ashtuchkin/vive-diy-position-sensor/(threads)

Thread 1 (2016-10-31):

Pictures for readme.md

ashtuchkin, 2016-10-31:
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

!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

[image](https://cloud.githubusercontent.com/assets/627997/19845426/06c64bb2-9ef4-11e6-8d2b-1bbfbc5ec368.png)

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

ashtuchkin, 2016-11-07:
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

ashtuchkin, 2016-11-13:
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

ashtuchkin, 2016-11-13:
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

ashtuchkin, 2016-11-13:
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

ashtuchkin, 2016-11-13:
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

ashtuchkin, 2016-11-13:
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

ashtuchkin, 2016-11-13:
| Top view | Bottom view |
| --- | --- |
| 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 | 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 |

ashtuchkin, 2016-11-13:
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

ashtuchkin, 2016-11-13:
| Teensy connections |  Full position tracker |
| --- | --- |
| 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 | 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 |

ashtuchkin, 2016-11-28:
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

ashtuchkin, 2016-11-28:
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

Closed 2016-10-31.

Thread 2 (2016-11-13):

Create a more convenient method of providing base station geometry.

ashtuchkin, 2016-11-13:
Base station positions and direction matrices are hardcoded in geometry.cpp (`lightsources`).

I'm currently using an [OpenVR](https://github.com/ValveSoftware/openvr) hello world sample on my main machine to get it (by inspecting m_rmat4DevicePose in debug mode). This is obviously not sustainable.

Subtasks:
 - [x] Keep the matrices in EEPROM.
 - [x] Create interface to set them via USB.
 - [x] Create a way to determine the matrices for a setup - special application?

paralin, 2016-12-01:
The real Vive controllers and headset do it automatically, since they have a lot of sensors and know the exact geometry of all of those sensors, it must be quite easy to derive the positions of the base stations. The room calibration is primarily used to figure out the ground + play area, I suppose. The official sensors can determine the base stations relative positions without calibration or pre-set values. I think it would be possible for us to do this as well *if* we have multiple sensors on the quad with pre-calibrated positions

mpinner, 2016-12-08:
I'd be interested to ease the process by which we're to determine the positions and direction matrices. I got the OpenVR project working am able to inspect the m_rmat4DevicePose as well. The data from there (int[16]) didn't match format of our lightsources[2] (See Below)

I was thinking i could build a little windows app that outputs the correct lighthouse calibration information (direction and position). i agreed the eeprom is a nice way to go. i'll look into something there as well.

thanks for all your work and documentation.

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

ashtuchkin, 2016-12-08:
Yeah, as you can see the matrix there is 4x4 with the last column being
(0,0,0,1). For lightsource I'm using the top-left 3x3 sub-matrix (rotation)
and 1x3 position which is the last row of the 4x4 matrix above.

--
Alexander Shtuchkin

On Thu, Dec 8, 2016 at 10:41 AM, matt pinner <notifications@github.com>
wrote:

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

mpinner, 2016-12-12:
Super. this worked great. Thanks!

all the HTTCC devices are in there. it is fascinating getting the positioning matrices for all the device.

 i wonder what it takes to build your own into the system?

ashtuchkin, 2017-01-23:
I updated the project to allow runtime configuration (with data stored in eeprom) and created a small app to easily get the base station geometry in needed format (https://github.com/ashtuchkin/vive-diy-position-sensor-geometry-getter). Will update the docs soon.

Closed 2017-01-23.

Thread 4 (2016-12-05):

TS3633-CM1 Module

abencomo, 2016-12-05:
Hi Alexander,

Will it possible to use the [TS3633-CM1 Module](https://www.triadsemi.com/product/ts3633-cm1/) instea of building your own [sensor board](https://cloud.githubusercontent.com/assets/627997/19845384/a4fce0e4-9ef3-11e6-95e4-6567ff374ee0.png)?

ashtuchkin, 2016-12-05:
I haven't tried it yet, but it should.

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

abencomo, 2016-12-06:
I ordered a few of the TS3633-CM1 Module so I'll let you know if it works.

I noticed that you use three(3) photodiodes optical sensors, but it seems that only one pin is connected from the Teensy to the TLV2462IP.  Are you fussing the values from the optical sensors?

BTW, I was able to build your project (i.e. the firmware) using eclipse as shown below.

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

ashtuchkin, 2016-12-06:
Cool! I think I'll be able to experiment with TS3633-CM1 as well, but I definitely want to hear from you as well!

Yeah, those 3 photodiodes are connected in parallel to make it possible to cover the whole top hemisphere. It works fine, as the beam is almost as large as the gap between them and it looks like just a wider pulse.

I'm glad you compiled it in eclipse - did you need to do anything special? Should I add additional instructions?

abencomo, 2016-12-07:
No, I didn't.  You did such a good job setting up the code that everything worked out of you repo.  BTW, are you in the bay area near SF?

ashtuchkin, 2016-12-07:
That's great :) yeah I live in SF

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

abencomo, 2016-12-07:
Great, I'm at Ames (Moffett Field) near you.  I should have the TS3633-CM1 by Thursday or Friday. Cheers!

abencomo, 2016-12-20:
Hi Alex,

The TS3633-CM1 modules are in backorder so they haven't arrived yet.  In the meantime, I want to confirm a few things.

Are you using only one Vive Base Station in your video?  If that is the case, then did you switch it to mode "A"?

Is the Vive Base Station connected to your laptop via Bluetoorh?

And, do you need to have SteamVR running in your laptop?

Cheers!

ashtuchkin, 2016-12-20:
Hey Al,

> Are you using only one Vive Base Station in your video? If that is the case, then did you switch it to mode "A"?
No, both are used. It's actually exactly the same setup as I use for regular Vive games. Modes B and C

> Is the Vive Base Station connected to your laptop via Bluetoorh?
I have a gaming desktop and they are probably connected via Bluetooth, yes.

> And, do you need to have SteamVR running in your laptop?
I have SteamVR running, but it's just to wake up the stations. AFAIK there's no realtime communication between the stations and desktop.

abencomo, 2016-12-20:
Hum? That means you have a HMD in the loop.  Darn it.  It would have been great if only your IR receiving sensor with the Teensy and the base stations were the only components required.

ashtuchkin, 2016-12-20:
Well, after waking stations up I can shut down desktop and hmd, so it's not
involved. Only base stations and sensor are needed.

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

ashtuchkin, 2016-12-20:
You can also set up base stations to not go to sleep at all

On Mon, Dec 19, 2016 at 5:55 PM Alexander Shtuchkin <ashtuchkin@gmail.com>
wrote:

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

abencomo, 2016-12-20:
Keeping them from going to sleep is a good suggestion.  However, you still need the hmd to initiate the system before the quadcopter takes off, correct?

I also noticed that in your videos you're using a Mac laptop, were you able to run SteamVR on the Mac?

Thanks Alex for taking the time to clarify all these things.

ashtuchkin, 2016-12-20:
 I'm not sure, but just connecting base stations to power seems to be
enough to initiate. The system's geometry is a different  case - for now,
you need to calibrate the room using Vive's calibration and copy/paste the
matrices to the sensor. After that, only base stations are needed.

AFAIK SteamVR is not supported on Mac. I have a Windows gaming pc to play
vive.

--
Alexander Shtuchkin

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

mpinner, 2016-12-20:
the TS3633-CM1 Module works great!

@ashtuchkin i made a blog post highlighting your work:
https://blog.crashspace.org/2016/12/position-aware-device/

thanks again!

abencomo, 2016-12-20:
That is great. Thanks @mpinner for confirming that!  Now I cannot wait until mine arrived. Santa please, I have been good this year.

ashtuchkin, 2016-12-26:
I just received TS3633-CM1 module and checked it's output with oscilloscope, looks great, should work with the code in this repo with minor adjustment due to inverted envelope:

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
Channel 1: TS3633-CM1
Channel 2: Valve's own sensor (Alan Yates sent me a bunch)
Channel 3: My DIY sensor.

abencomo, 2016-12-31:
Hi Alex,

Are you planning to update the repository with those minor adjustments to handle the inverted envelope?

ashtuchkin, 2017-01-01:
Yep, as soon as I'm back from a vacation in mid jan. Open for PRs if you
need it faster, though.

--
Alexander Shtuchkin

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

erwincoumans, 2017-01-07:
Very cool, can you explain how to connect the TS3633-CM1 to Teensy and what minor changes are needed?

erwincoumans, 2017-01-07:
Great, I used Adrian Wong's change and connected the TS3633-CM1 to Teensy 3.2 and it works.
See image at the bottom here: https://github.com/erwincoumans/vive-diy-position-sensor#ts3633-cm1

How can we connect multiple TS3633-CM1 sensors?

almostsquare, 2017-01-10:
Pull request for inverted envelope along with changes in anticipation of servicing 4+ TS3633-CM1 sensors is available at https://github.com/ashtuchkin/vive-diy-position-sensor/pull/10. Instructions on how to modify board wiring to run side-by-side is provide in the PR.

This is my first PR, so please provide any feedback. I may not be structuring it correctly, so I'm happy to change things around as needed.

Thread 5 (2016-12-07):

STL for 3D printed part

cmcollander, 2016-12-07:
My apologies if this is already posted but I just missed it.
Could you publish the STL file for the 3D printed part?
Thanks!

r1b4z01d, 2019-01-21:
I know this is years old but here is a jig I created for the IR sensors.
https://github.com/r1b4z01d/microz01d/blob/master/SensorJig.stl

Closed 2020-12-07.

Thread 6 (2016-12-08):

Add 1-click-bom file

abencomo, 2016-12-08:
With Digikey you also just share your cart already loaded as shown here:

http://www.digikey.com/short/3595z7

Thread 7 (2016-12-15):

Questions: Trying to reproduce the setup

imuguruza, 2016-12-15:
Hey there,

I'm trying to reproduce your results. Firstly I'm checking that the hardware I have mounted is OK. I have reproduced you schematics in a board that looks like this:

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

I have placed 2 photodiodes, turned ~180º a positioned one of each lighthouses in fron of each photodiode. Once turned on, I'm seeing the next signal at the output of the 2nd OpAmp:

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

Classifying the signals:
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

(I have seen that there are 4 different group of pulses and starts over again)

I have noted down sync pulses and hits. As can be observed, in the 3rd & 4th, there are two hits. I'm not sure why this happens.

This are my doubts:

- The 2 sync pulses are not separated in 400us, I'm seeing ~2.4ms:
- In 3rd and 4th group of pulse, I'm seeing 4 pulses( 2x sync + 2x hits), does this means I'm seeing a kind of reflection or that in that period I'm reading in both photodiodes the ray which has been sent by one of the lightshouse? Are you also reading something like this?

As far as I understand, the pulses generated using 2 lighthouses are:

- 1x sync (lighthouse A) + 1x sync (lighthouse B) + 1x Horizontal lighthouse A
- 1x sync (lighthouse A) + 1x sync (lighthouse B) + 1x Vertical lighthouse A
- 1x sync (lighthouse A) + 1x sync (lighthouse B) + 1x Horizontal lighthouse B
- 1x sync (lighthouse A) + 1x sync (lighthouse B) + 1x Vertical lighthouse B

Calculation wise, I do not have clear if knowing the source of each pulse if its crutial or not. Meaning if it is important to know if the ray has been generated by lighthouse A or B and if we need to know if it's a vertical or horizontal. Is there any way of knowing this? Is it crutial?

Great job btw

ashtuchkin, 2016-12-16:
Hey, great job, it's almost working! From the pictures you posted, it looks like the stations are not in sync - the distance between pulses should be ~400us, I've never seen it different. Is the current setup working with the Vive? Do both stations have green LEDs? Do you have one of them set to "B" and the other to "C"?

> In 3rd and 4th group of pulse, I'm seeing 4 pulses( 2x sync + 2x hits), does this means I'm seeing a kind of reflection or that in that period I'm reading in both photodiodes the ray which has been sent by one of the lightshouse? Are you also reading something like this?

Probably reflection or sync problems. When it's the same sweep, the difference between pulses is on the order of 10us.

> As far as I understand, the pulses generated using 2 lighthouses are: ...

Yes, that's right.

> Calculation wise, I do not have clear if knowing the source of each pulse if its crutial or not. Meaning if it is important to know if the ray has been generated by lighthouse A or B and if we need to know if it's a vertical or horizontal. Is there any way of knowing this? Is it crutial?

Well, it's crucial to map it to geometry to get the actual position. It's easy to determine which sync pulse is coming from which station by analyzing their width, see table on [this page](https://github.com/nairol/LighthouseRedox/blob/master/docs/Light%20Emissions.md). skip is station, rotor is horizontal/vertical. data can be ignored.

imuguruza, 2016-12-16:
>From the pictures you posted, it looks like the stations are not in sync - the distance between pulses should be ~400us, I've never seen it different. Is the current setup working with the Vive? Do both stations have green LEDs? Do you have one of them set to "B" and the other to "C"?

You're right, I had the stations ins "A" and "B". I have switched to "B" abd "C" and now I'm seeing the pulses right. The sync pulses with a delay of 400us and a sinlge hit per sweep

imuguruza, 2016-12-16:
>Well, it's crucial to map it to geometry to get the actual position. It's easy to determine which sync pulse is coming from which station by analyzing their width, see table on this page. skip is station, rotor is horizontal/vertical. data can be ignored.

So if I get it, it means that:

- j0 & j1 -> Active lighthouse & Vertical sweep.
- k0 & k1 -> Active lighthouse & Horizontal sweep.
- j2 & j3 -> Inactive lighthouse & Vertical sweep.
- k2 & k3 -> Inactive lighthouse & Horizontal sweep.

So I should never see, in the same sweep, two sync pulses that belongs to j0/1 or k0/k1.
I have observed that "inactive" sync width signals happens for both sync signals and that photosensors also reads ray. Should we ignore this event??

ashtuchkin, 2016-12-16:
It should be
'''
"active" sync station B -> "inactive" sync station C -> horizontal sweep
pulse station B
.. same .. vertical pulse
"Inactive" sync station B -> "active" sync station C -> horizontal sweep
pulse station C
.. same.. vertical
'''

Also keep in mind that pulse lengths in that table are not absolute -
because of the filters and non-ideal opamps it can differ, but all in the
same amount. I have some code to adjust it in the repo.

On Fri, Dec 16, 2016 at 3:31 AM Iñigo Muguruza <notifications@github.com>
wrote:

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

imuguruza, 2016-12-19:
Yeah, now I'm able to see pulses correctly. Thanks for you help!

Closed 2016-12-19.

Thread 8 (2016-12-20):

Time offset doubt

imuguruza, 2016-12-20:
Hey there,
I continue understanding how the calculations works.
Just a detail that I'm not sure:
Following the [calculation page](https://github.com/ashtuchkin/vive-diy-position-sensor/wiki/Position-calculation-in-detail), I have a doubt about the timing called `< time offset in us>`.

Is supposed the timing since the sync pulse is generated, or is ended?
I think graphically explained is more clear, this value is `x`, `y`or `z` delay (in us)?

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

I don't see it in the sourcecode...

Thanks!

ashtuchkin, 2016-12-20:
Great question! It's Z. We start the "cycle" when the first sync pulse
starts.

Note, that this is independent on which station is currently
laser-sweeping, the timing is always counted from the first sync pulse,
which can be produced by a different station.

--
Alexander Shtuchkin

On Tue, Dec 20, 2016 at 8:22 AM, Iñigo Muguruza <notifications@github.com>
wrote:

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

imuguruza, 2016-12-21:
OK, thanks for the info

Closed 2016-12-21.

Thread 9 (2017-01-07):

Explanation

Bloodline95, 2017-01-07:
Hi,
I'm currently trying to get it working on a XMC 4500 Relax Kit, because I have to use an Infineon controller for my Bachelor Thesis. My current problem is, that I always get a negative angle between -1.2 and -1.3°.
So could you please explain the formular for the angle. Right now I don't really get all of it completely.

ashtuchkin, 2017-01-07:
Hey, which particular angle are you referring to? Have you seen this:
https://github.com/ashtuchkin/vive-diy-position-sensor/wiki/Position-calculation-in-detail

Bloodline95, 2017-01-07:
Yeah, I mean the first formular. I get my measured time in ns, so I divide it by 1000. But I always get a negative angle between -1.2 and -1.3°.

ashtuchkin, 2017-01-07:
Negative angle in general is fine; it just means that the sensor is to the left of center line (if it's a horizontal sweep).

What is the range of timings you get? Maybe the problem is in the timing module or the unit conversion?

The formula itself should be quite simple: `angle = (time_in_microsec - 4000) * PI / 8333.3`

Bloodline95, 2017-01-10:
Here is a OneDrive link to the data I get. I fear that the code I use to get the time intervals is wrong.

[https://1drv.ms/u/s!At2vyt_CVX2WlwpsfbrrJKduDgek]()

`//calculate lenght of the sync pulse`

`i[0] = last_signal_period;`
`i[1] = last_signal_duty;`
`sync_pulse = (i[0] - (i[1] / 100 * i[0])) / 1000;`
`//sync pulse decoding`
`if(decode())`
`{`
`	angle =(i[0] / 1000 - 4000) * M_PI / 8333;`
` }`

I'll write a new code today with another methode to get the timings.

ashtuchkin, 2017-01-10:
Yeah the timings seem wrong. Too much variation. Be sure to calculate timing from the beginning of sync pulse to the center of the laser sweep cycle.

One more thing - you're getting angle in radians, not degrees.

Bloodline95, 2017-01-10:
Could it be, that it just won't work with only one Lighthouse Box?

Bloodline95, 2017-01-12:
I got my hands on an oscilloscope. I get some really weird pulses out of my sensors. I think, that my Lighthouse Box searchs for the second one, which is simply not there.

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

ashtuchkin, 2017-01-29:
Did you manage to make it work? I'm wondering what the issue was.

Bloodline95, 2017-02-20:
No I'm still struggling. Is it possible that it won't work without a second box?

ashtuchkin, 2017-02-20:
Yeah, it won't work with just one box. Two needed for a 3d fix. Are you trying to get it running without a full HTC Vive set? It might be possible to get the angles with two stations, but if you want to get xyz position, then you'll somehow need to get their position and rotation very precisely, which I don't know how to do without the full set.

ashtuchkin, 2017-02-20:
Just saw you asked this question a month ago, which I missed, sorry for that!

abencomo, 2017-02-20:
Hi Alex, I just saw your first Alpha release.  Congratulations!  I'll give it a try later this week.

The release comment says, "_**(almost) everything is configurable and users can just upload the .hex file**_"

Is that because we still need to run SteamVR, calibrate the room using Vive's calibration, and copy/paste the matrices to the sensor?

ashtuchkin, 2017-02-21:
Thanks All! This is the wrong thread for this conversation, though :) don't
be afraid to create a new issue to discuss it.

As for your question - yes, we need base station geometry from steamvr, but
also how many sensors, objects, what format, where to stream, etc. See
small example in src/settings.cpp.

On Feb 20, 2017 11:05 AM, "Al B" <notifications@github.com> wrote:

Hi Alex, I just saw your first Alpha release. Congratulations! I'll give it
a try later this week.

The release comment says, "*(almost) everything is configurable and users
can just upload the .hex file*"

Is that because we still need to run SteamVR, calibrate the room using
Vive's calibration, and copy/paste the matrices to the sensor?

—
You are receiving this because you commented.

Reply to this email directly, view it on GitHub
<https://github.com/ashtuchkin/vive-diy-position-sensor/issues/9#issuecomment-281159144>,
or mute the thread
<https://github.com/notifications/unsubscribe-auth/AAmVHdcJLrXob8mwT2C_B-L39wugzhHQks5reeP0gaJpZM4LdbF0>
.

jguanz, 2017-02-27:
Hello,

@Bloodline95 Did you determine what was causing your unexpected oscilloscope readings?  I'm also getting something similar.  I'm using one lighthouse (no sync cable), in mode A, and here are my readings:

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

jguanz, 2017-02-27:
Well shoot, the sensor was too close to the lighthouse.  We pulled it back to ~3 feet and that fixed it.

Closed 2021-07-06.

Thread 12 (2017-01-27):

Battery pin connectors

abencomo, 2017-01-27:
Hi Alex,

I hope you had a good time during your vacation, welcome back.  I noticed that you are not using the battery XT-60 connector; which makes sense since otherwise your station would have not been available to swap batteries.  Would you mind letting me know the pin connector are you using and did you purchased them from [here](https://www.mill-max.com/)?

Thanks, and best regards!
~~Al

ashtuchkin, 2017-01-29:
Yeah, I had some good time, thanks :)

I'm actually using XT-60 in three places:

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

But for the connection between battery and copter, I'm using [these pins](https://www.digikey.com/product-detail/en/mill-max-manufacturing-corp/0851-0-15-20-82-14-11-0/ED90512-ND/2532965).  3x of them for each power wire (8x3= 24 Amps) and 1x for additional wires to balance charging.

Closed 2017-02-20.

Thread 14 (2017-02-23):

Teensy serial communication explanation

kajep09, 2017-02-23:
Hi,

I have a Teensy 3.6 and have compiled the project (on Windows) and uploaded to the Teensy (Using Teensyduino after generating the .hex file with Ninja). However, after programming and rebooting the Teensy I was under the impression I should be able to connect to it via serial (even if it doesn't output any meaningful data), but I cannot see the device as a serial port on neither Ubuntu or Windows. On Windows it shows up as "Unknown USB device (code 43)" and on Ubuntu I cannot see anything related under /dev/tty.

If I program the Teensy with a standard Arduino serial example I can connect to it over serial on both Ubuntu and Windows.
So before I go mad troubleshooting anything related to Teensy and serial communication, I was wondering if there are some settings that I should have configured in the project before it works?

I realize that I haven't got the correct matrices for the base station poses, but I just want to verify that the program is actually running correctly on the Teensy before I hook up my sensor board and spend time on the computer with the Vive connected (at a separate location).

TL;DR. I cannot connect to the Teensy over serial after building and uploading the project. Are there any settings that need to be configured for this to work?

kajep09, 2017-02-23:
Now I tried using "TyQt" on Windows and when I try to upload the firmware it tells me that the firmware is only compatiable with Teensy 3.1 and 3.2 - not sure why I didn't think about board version compatibility before. I never got any warning or error message when uploading with TeensyDuino, so I guess I never thought about it.

Can anyone confirm that the project is only compatible with the old versions of Teensy (3.1 and 3.2)? I should probably open a new issue to discuss board version compatibility if this is the problem. Do you have any idea how much would need to be changed for it to work on another Teensy version?

kajep09, 2017-02-23:
Hi again,

Sorry for spamming so much, but I think I have mostly solved my own problem. This is the first time I've used the Teensy MCUs, but I have now changed the following lines in the teensy-arm.toolchain.cmake file to match up with the Teensy 3.6 instead of the 3.2. I don't know if the Teensyduino verison is used for anything, but I changed it to match mine (1.35) anyway.
 Now I can build and upload the firmware to my Teensy 3.6 and it shows up as a serial device.
Through TyQt's serial monitor I can see _"Error: No inputs configured. Please enter '!' to go to configuration mode and setup at least one input."_ and _"Unknown command 'c0'. Valid commands: view, <module> <settings>, reset, reload, write, continue."_ etc.
So I guess now it's a matter of figuring out what settings to configure.

set(TEENSYDUINO_VERSION "135" CACHE STRING "Version of the Teensyduino SDK")
set(TEENSY_MODEL "MK66FX1M0" CACHE STRING "Model of the Teensy MCU")

set(TEENSY_FREQUENCY "180" CACHE STRING "Frequency of the Teensy MCU (Mhz)")
set_property(CACHE TEENSY_FREQUENCY PROPERTY STRINGS 180 96 72 48 24 16 8 4 2)

ashtuchkin, 2017-02-23:
Yep this is exactly the way I wanted to suggest. Glad you figured it out!

Btw I'll merge the "rewrite" branch very soon so you might wanna start
using that right away. I'll also provide compiled versions of the library
as hex files. To make it easier for to use.

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

Closed 2017-02-23.

Thread 15 (2017-03-07):

Consider specifying a license

albrow, 2017-03-07:
Firstly, thank you so much for publishing this!

Unless I'm missing something, this repo currently does not specify an open source license. I was wondering if you would consider adding one? I would suggest the [MIT License](https://opensource.org/licenses/MIT), which is what I use for most of my own open source projects, but there are a lot of other good licenses out there.

Adding a license removes any ambiguity about who is allowed to use the code, circuit diagrams, etc. and what they are allowed to use it for. It also tends to make people more willing to contribute back :)

ashtuchkin, 2017-03-08:
Hey, I'm glad it's useful. The license is mentioned in the list of features in the beginning of readme.. Do you think I need to add it somewhere else? What's the first place you look into when you want to know which license is used?

ashtuchkin, 2017-03-08:
Ok, added the file LICENSE.txt, this should be more explicit. Thanks!

albrow, 2017-03-08:
@ashtuchkin thanks for adding this! Makes it a lot more explicit and easier to find.

Closed 2017-03-08.

Thread 16 (2017-03-12):

Is this as accurate as vive tracker puck?

jcklpe, 2017-03-12:
This seems cool. I'd like to able to create some small trackers to keep track of physical objects in VR. Things like knowing where my keyboard and mouse are. But these are only accurate to 2mm? That doesn't seem very accurate. Is there anyway to improve that?

ashtuchkin, 2017-03-12:
What kind of accuracy would be enough for your task? The position can be
averaged across several samples to get better values, at the expense of
slightly sluggish response. But it's hard to get better than 0.5-1.0 mm.

As for the title of the issue - we don't know the accuracy of vive tracker
(afaik it's not out yet), so I cannot compare. I think it'll be similar.

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

thedonquixotic, 2017-03-12:
Aren't the controllers and headset supposed to be submillimeter tracking?
Maybe that's just marketing hype I heard though.

On Sat, Mar 11, 2017, 21:24 Alexander Shtuchkin <notifications@github.com>
wrote:

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
--
--
David Aslan French
http://www.jack-a-lope.net/

ashtuchkin, 2017-03-12:
Well, technically 0.99mm is submillimeter tracking :)

Btw, it's hard to define what we actually mean by accuracy. Is it the STDEV
of position readings in a static position? Is it max difference between
actual position (measured by ruler) and position provided by sensor across
the whole tracking volume? Or difference between what HTC Vive original
tracking devices give and what the sensor gives?

These three will give quite different results.

--
Alexander Shtuchkin

On Sun, Mar 12, 2017 at 9:15 AM, David French <notifications@github.com>
wrote:

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

thedonquixotic, 2017-03-17:
@ashtuchkin That makes sense. Would you say on an experiential level it is similar in accuracy to a Vive controller or headset?

I'm going to be build it anyway but I'm curious on your thoughts. I decided if nothing else I want to build 2, one for my headphones and one for the hat rack I keep my vive and controllers on. That way I can mount and dismount in VR more easily :D

ashtuchkin, 2017-03-20:
It's similar, as long as the base stations are not occluded. Currently the main downside of this diy project is it doesn't handle situation where only 1 base station is visible, unlike the vive puck. I'm doing some experiments on it, but not sure how close I can do.

Btw, I ported this project to Particle Photon board as well, so now it can be used without wires.

Closed 2021-07-06.

Thread 17 (2017-03-20):

Tracking with a single station

paralin, 2017-03-20:
The Vive Puck is able to track with just a single base. I'm interested in replicating this with the DIY solution. What would be required to achieve this? I'm assuming multiple sensors positioned similarly to the puck with some kind of extremely low tolerance calibration in place to know their relative positions, correct?

mwturvey, 2017-03-20:
To be clear, are you wanting to develop your own tracked object that is accessible to be games using the Vive, or are you wanting to build your own tracked object that only uses the lighthouses for a "roomscale gps" kind of solution?

abencomo, 2017-03-20:
@mwturvey  In my case, it's the latter.  However, I have 2 lighthouses. Just to be clear.

paralin, 2017-03-20:
Latter, for robot localization without communication. I think it's the most interesting part of the lighthouse concept. I'd prefer to use one light house rather than two, to avoid having to calibrate anything but the relative pose of the sensors. What do you think?

mwturvey, 2017-03-20:
Definitely possible, but it's been surprisingly difficult to get the algorithms to work well for single lighthouse tracking.  I've been working on a similar project at GitHub.com/cnlohr/libsurvive. That project's goal is to put together an entire software stack so you can use your Vive on a less capable system.  My interest is to get a high precision indoor positioning that I can use to build a self driving wheelchair.  A big part of the effort so far has been getting the pose detection using the lighthouses.  Also, work has been done to successfully reverse engineer the protocol used by the controllers and hmd. I'm not aware of any other project that is working to determine pose from one lighthouse (other than the native Valve/HTC software), but would be interested to hear of someone had heard of any other similar effort.

paralin, 2017-03-20:
@mwturvey very cool. Ideally I'd use one base station to track a MAV as it does precision landing. The pose relative to the lighthouse is all that's required really. I think with the simplification of using a single base and not dealing with trying to do room calibration or HMD rendering could allow the code to be drastically more concise. Thoughts?

mwturvey, 2017-03-20:
Adding a second base station will only roughly double the computational work.  The two reasons I'm aware of to use two lighthouses are 1) redundancy in case of occlusion and 2) the uncertainty in position is not uniform in all axes.  Specifically, there is a lot more uncertainty in the distance from the lighthouse than side to side.  (On the order of a couple centimeters vs less than a mm).  By having two lighthouses, you can get a much more precise fix.  I expect that you'll need a microcontroller that natively supports floating point calculations in order to get high frequency position info (I.e. raspberry pi) although a lesser system is likely going to be possible, too.

ashtuchkin, 2017-03-20:
Multiple sensors on rigid frame + precise calibration + single-base station algorithm would be a lot harder to implement than the current way of using one sensor, two base stations and offload calibration to htc vive. I also think you'll need accelerometers for single-base positioning, otherwise location uncertainty would be too high in the direction of that base station, like @mwturvey said.

@mwturvey nice project! What hardware do you use?

paralin, 2017-03-20:
I plan to use a filter anyway to merge the IMU data with the Vive data, taking into account the uncertainty in the Vive positioning and potentially also taking a range finder as another input.

The issue is I would really like to reduce the amount of hardware involved. Dropping to one base helps a lot. I think the loss of precision you describe is tolerable, +/-5cm should be fine.

mwturvey, 2017-03-20:
From the numbers I've seen,  precision in the depth dimension with a single lighthouse when using the Vive software stack ( which certainly uses the imu data) is about 2cm.
For hardware, right now I'm just using a desktop and laptop that are a few years old -- nothing fancy.  I have a separate project where I was using a an Arduino Due connected to a rigid 6 sensor array ( using the Triad part) and was able to get good angular readings there, but I'm now convinced that the sure isn't going to be well suited to crunching the floating point numbers needed for pose estimation using a single lighthouse.  The bulk of the libsurvive work right now is pretty much all on X86 he to get the current code working and stable, although there is interest and desire by some to go get it working on a micro-- especially focusing on an esp32.  As for tracking hw, I've been using a pair of lighthouses, the custom Arduino solution above, a single Vive controller, and I've got a tracker I've been trying to figure out the USB protocol for, but it appears to be more different than the controller's protocol than I expected and is slowing me down.  Pretty much everyone else wiring on libsurvive just has a standard HTC Vive setup.

Closed 2021-07-06.

Thread 18 (2017-03-20):

Use base station calibration values

ashtuchkin, 2017-03-20:
We currently don't use them and that leads to ~9cm distance between rays.

See
https://www.reddit.com/r/Vive/comments/5s23ha/lighthouse_factory_calibration_values/
https://github.com/cnlohr/libsurvive/issues/18

Thread 19 (2017-03-28):

rvdm88 gif: Wrong H sweep direction ?

DoNck, 2017-03-28:
Hi there !

In the description, you are using a gif animation which I think is built from rvdm88's video.

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

Looking at a [960fps slow motion video](https://www.youtube.com/watch?v=avBt_P0wg_Y), I can see the wheels sweeping from left to right, and from bottom to top (looking at the optical parts).

So I'm pretty surprised by the direction of the horizontal sweep (the one highlighting the vertical plane) in the animation from rvdm88. I think it should go ***from left to right***.

Am I right ?

Note: I also posted [a comment](https://www.youtube.com/watch?v=J54dotTt7k0&lc=z234vvpxblb2c3wlhacdp435l13dswd3x0pf4vxaeipw03c010c) to ask the same question directly on rvdm88's last version of the video ["HTC Vive Lighthouse Chaperone tracking system Explained"](https://www.youtube.com/watch?v=J54dotTt7k0&lc=z234vvpxblb2c3wlhacdp435l13dswd3x0pf4vxaeipw03c010c).

PS: Thanks for sharing !

ashtuchkin, 2017-04-21:
Yes! You're definitely right. It's happening from left to right if you're looking at base station from sensor point of view.

Closed 2017-04-21.

Thread 20 (2017-03-28):

Right / Left meaning

DoNck, 2017-03-28:
Hi,

I am pretty confused reading your explanation in the wiki: [step-2-calculate-3d-planes-from-stations](https://github.com/ashtuchkin/vive-diy-position-sensor/wiki/Position-calculation-in-detail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).
I feel like the text and drawing are not coherent regarding the x axis:
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
You wrote ***"X is left"*** but when I look at your drawing, ***I see X going to the right***.
***Is there something wrong in your text/drawing or did I missunderstand what you actually meant by "left" ?***

This goes out of the scope of this project, but left/side terms are actually pretty unclear to me in a lot of vive lighthouse related discussions as people may use different point of views:
- looking at the face of lighthouse
- looking at the environment from the lighthouse point of view
- looking at 2D axis of a picture showing a lighthouse system

I think something we all agree on is the naming of a faces on a cube:
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
I think using this vocabulary could ease discussions and reading/writing documentation.

ashtuchkin, 2017-04-21:
I meant "X is going right-to-left from the point of view of base station", i.e. when you look in the direction of inverse Z ("Station looks here" on the pic). Specifically, at the center X=0, then negative values to the right and positive to the left.

I agree it's confusing. Not sure what to do though, as naming the faces of the cube doesn't make it clear to me, because you also need to specify the rotation of the cube, right?

Closed 2017-05-21.

Thread 21 (2017-04-06):

Compiler

DarioRQC, 2017-04-06:
Hi,

I'm quite new in Github and I don't understand how can I compile or modify your code.
I don't know how I have to use the Cmake 3.5+

If I use Arduino IDE compiler or Visual micro , could I program the teensy board?

Thanks!

ashtuchkin, 2017-04-06:
What OS are you using? Arduino IDE is, unfortunately, not supported, as
well as Visual Studio. Current way to compile is using command line.

--
Alexander Shtuchkin

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

DarioRQC, 2017-04-07:
Hi Alexander,

Thank you for answering.

I'm using Windows 10. How can I learn to use this programs?

What does "%path%" means?

Hope you can help me.

Regards,

Darío

________________________________
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

DarioRQC, 2017-04-07:
How can I solve ""Please provide PLATFORM env variable"?

ashtuchkin, 2017-04-07:
Oh! Good you've got to this. I need to update the docs, but for now you
need to add environment variable named "PLATFORM" with value "teensy"
before running CMake.

For example, type these commands:
```
set PLATFORM=teensy
CMake.exe  ... the command line you provided before
```

More info on environment variables:
https://superuser.com/questions/284342/what-are-path-and-other-environment-variables-and-how-can-i-set-or-use-them

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

ashtuchkin, 2017-04-10:
Windows is not my main platform, but I'll try to send you cmake settings
when I return home. From the error it seems something's wrong with finding
toolchain and C compiler.

Redbear is possible, but not easy - it's a different platform from teensy
and particle, so input code would need to be reimplemented, as it's
chip-specific.

Look into platform-teensy and platform-particle for a sense of how much
code will need to written to support new platform.

On Apr 10, 2017 1:47 AM, "DarioRQC" <notifications@github.com> wrote:

Please, could you share with me a screenshoot of your Cmake config?

I attach my config.

[image: cmake]
<https://cloud.githubusercontent.com/assets/20417021/24853259/5d0b6ab8-1dd2-11e7-920c-7fda204c0bfb.png>

I have this error:

The C compiler identification is GNU 6.3.1
The CXX compiler identification is GNU 6.3.1
Check for working C compiler: D:/Programas/GNU Tools ARM Embedded/6
2017-q1-update/bin/arm-none-eabi-gcc.exe
CMake Error at D:/Users/Dario/Dropbox/Documents/GitHub/vive-diy-
position-sensor2/platform-teensy/teensy-arm.toolchain.cmake:24 (message):
GNU ARM Embedded Toolchain not found. Please install it and provide its
/bin directory as a TOOLCHAIN_BIN_PATH variable.
Call Stack (most recent call first):
D:/Users/Dario/Dropbox/Documents/GitHub/vive-diy-position-sensor2/bin/
CMakeFiles/3.8.0-rc4/CMakeSystem.cmake:6 (include)
D:/Users/Dario/Dropbox/Documents/GitHub/vive-diy-position-sensor2/bin/
CMakeFiles/CMakeTmp/CMakeLists.txt:2 (project)

CMake Error: CMAKE_C_COMPILER not set, after EnableLanguage
CMake Error at D:/Programas/CMake/share/cmake-3.8/Modules/CMakeTestCCompiler.cmake:37
(try_compile):
Failed to configure test project build system.
Call Stack (most recent call first):
CMakeLists.txt:5 (project)

is it possible to export your code to Redbear duo?

Thank you,

Cheers,

Darío

—
You are receiving this because you commented.

Reply to this email directly, view it on GitHub
<https://github.com/ashtuchkin/vive-diy-position-sensor/issues/21#issuecomment-292887226>,
or mute the thread
<https://github.com/notifications/unsubscribe-auth/AAmVHXR_niq_nrp-Wsk7PF6G8RStZ3O5ks5rueyOgaJpZM4M16kb>
.

DarioRQC, 2017-04-10:
Hi,

Finally, I succeed with the compiling process.

I attach you a .docx with the steps for Windows.

How can I apply the .hex to teensy?

To obtain the raw data do I need particle?

thanks,

regards,

Darío

________________________________
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

ashtuchkin, 2017-04-11:
Happy to hear that! Teensy has an updated program that you can download
from their website: https://www.pjrc.com/teensy/loader.html

Particle Photon is just a different platform with the benefit of included
wifi module. The functionality is otherwise similar to Teensy.

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

DarioRQC, 2017-05-09:
Hi ashtuchkin,

I'm trying to upload the .hex to Teensy 3.2 and the loader says "too large!"

I have Teensy 3.2 like you.

May I change some parameter in Cmake?

Regards,

ashtuchkin, 2017-05-09:
Is it an alpha .hex file, or you're compiling yourself? Did you add any
code?

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

DarioRQC, 2017-05-10:
I have compiled your code and I have tried with a new Teensy 3.2 board and now I can upload the .hex file.

Do I have to send any command through serial?
When I turn it on with all the connexions done, nothing happens in the serial monitor.

Can you share your .hex file?

Thank you for all :)

Regards

ashtuchkin, 2017-05-10:
Yes, you need to configure it through Serial before it starts sending you
data. See
https://github.com/ashtuchkin/vive-diy-position-sensor/blob/docs/docs/manual.md
for more info.

I uploaded a previous version of "my" .hex file here:
https://github.com/ashtuchkin/vive-diy-position-sensor/releases/tag/v1.0-alpha2
  It's almost the same as the current master.

Alex.

--
Alexander Shtuchkin

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

ashtuchkin, 2017-05-21:
Closing for now. Let me know if you have more questions.

Closed 2017-05-21.

Thread 22 (2017-04-19):

No position data

yancysang, 2017-04-19:
I have program the code and flashed the teensy.
Input the followings:
reset
sensor0 pin 12 positive
base0 origin -1.312959 1.813745 -1.120400 matrix -0.615478 -0.028460 -0.787640 -0.006982 0.999506 -0.030659 0.788123 -0.013371 -0.615372
base1 origin 1.332837 1.999052 1.053622 matrix 0.632380 -0.055890 0.772639 0.014321 0.998067 0.060475 -0.774526 -0.027179 0.631958
object0 sensor0

stream0 position object0 > usb_seria

continue

then,in debug model i type into the followings:

geom0 count
geom0 show

however,i can only receive
debug> geom0 show ObjectPosition0: accumulating.. debug> sensor0 pulses show Pulse0: accumulating.. ObjectPosition0: 38001ms: fix 0, pos 0.0000 0.0000 0.0000, dist 0.0000 | 39001ms: fix 0, pos 0.0000 0.0000 0.0000, dist 0.0000 | 40001ms: fix 0, pos 0.0000 0.0000 0.0000, dist 0.0000 | 41001ms: fix 0, pos 0.0000 0.0000 0.0000, dist 0.0000 | 42001ms: fix 0, pos 0.0000 0.0000 0.0000, dist 0.0000 | 43001ms: fix 0, pos 0.0000 0.0000 0.0000, dist 0.0000 | 44001ms: fix 0, pos 0.0000 0.0000 0.0000, dist 0.0000 | 45001ms: fix 0, pos 0.0000 0.0000 0.0000, dist 0.0000 | 46001ms: fix 0, pos 0.0000 0.0000 0.0000, dist 0.0000 (9 total)

How can I get the correct position information from teensy?

ashtuchkin, 2017-04-21:
What sensor do you use? If TS3633, you'll need to change polarity (positive -> negative).
If that doesn't help, look into the raw pulses data by typing `sensor0 pulses show` in debug mode.

yancysang, 2017-04-21:
I used three BPV22NF as IR Sensor.
The raw pulses to teensy is:
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
n config mode，it shows：
...
OBJ0    25375    0
OBJ0    26000    0
OBJ0    27000    0
...
when I type "sensor0 pulses show" in debug mode:
Pulse0: accumulating..
and type "sensor0 pulses show" shows:
Pulse0: 0 items
My devices:
Teensy 3.2
compile based on commit 8536d80
two lighthouse

ashtuchkin, 2017-04-21:
So there's  no pulses registered.. check pin number is correct, double
check electronics, try manually sending impulses to the pin and try to make
`sensor0 pulses show` to give you at least something.

Btw, people sometimes confuse how debug mode works. The usual flow is
following:
 1. Send command to determine what you want to monitor (I.e. sensor0 pulses
show). It will start monitoring, but won't give you outputs. There can also
be several commands to monitor several things.
 2. To get outputs once, send empty line (press enter). To get outputs
every second, send command 'c'. To get outputs more frequently, send e.g 'c
50' to output every 50ms.

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

ashtuchkin, 2017-05-21:
There was a bug with pulse input, which I fixed today. Please check current master and let me know if it helped. Thanks!

luoxz-ai, 2022-03-12:
Can you give a breadboard wiring diagram? thanks

luoxz-ai, 2022-03-12:
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

luoxz-ai, 2022-03-12:
Is the light blinking because the hardware isn't connected properly?

luoxz-ai, 2022-03-12:
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

luoxz-ai, 2022-03-12:
Is this breadboard wiring correct?

luoxz-ai, 2022-03-12:
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

luoxz-ai, 2022-03-12:
The output is the same without connecting the sensor.

Closed 2017-05-21.

Thread 23 (2017-04-23):

Can tracking be done on android?

GameFaceLabs, 2017-04-23:
Title says it all

ashtuchkin, 2017-04-24:
Theoretically yes. You'll need access to hardware timers, though. Precise
timing is critical.

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

GameFaceLabs, 2017-04-25:
Interesting. As it happens, we build a standalone VR headset powered by
Android, which we have built from scratch. I would love to ask a few
questions if you had time

On Apr 24, 2017 5:49 PM, "Alexander Shtuchkin" <notifications@github.com>
wrote:
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
mute
> > the thread
> > <
https://github.com/notifications/unsubscribe-auth/AAmVHSBhM3a0PT-QWtOUdsJJ_EWcz6q9ks5ry8AsgaJpZM4NFinS
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

ashtuchkin, 2017-04-25:
Interesting, are you planning to support HTC Vive positioning? Sure, ask
any questions you have!

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

Closed 2017-05-21.

Thread 24 (2017-04-23):

Setup Guide for Vive DIY Position Sensor

SquawkBirdies, 2017-04-23:
Hello,

I am trying to build a position sensor and I am trying to follow your instructions as closely as possible. I am using the Teensy 3.2 microcontroller and I have built the sensor board following your instructions and using identical components. I have flashed your v1.0-alpha .hex file to the Teensy. Here are my questions:

Oscilloscope measurement of sensor board output:
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

1. I connected the Teensy to my computer using USB and I opened a terminal to its serial port. I have tried 9600 baud and 57600 baud, but I do not receive any text.

2. If I understand you correctly, I need to use SteamVR setup to generate configuration values for my space which then have to be uploaded to the Teensy. You wrote a separate program to grab the configuration values, but once I get them, how do I upload them to the Teensy? From reading your code, there seems to be some way to do this over USB serial.

Thanks!

ashtuchkin, 2017-04-24:
Are you using one base station? Its a bit hard to see in the oscilloscope
pic, but with two stations you should have two big pulses and then a small
one for each cycle.

USB serial is the main configuration and data interface for this project,
so be sure to set it up correctly. What OS are you using? Try to go through
a getting started guide for teensy to set up the port, if it works with
simple echo-like app, then it will work with this project as well.

Also, be sure to press enter when you connect, to get the config> prompt.

After you connect, you'll be in configuration mode. You'll  need to
copy/paste the base station information from that other app, plus enter
which pin you use, etc. There's a doc in /docs directory to help.

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

unonu, 2017-04-26:
Hi ashtuchkin, I'm working with SquackBirdies.
To clarify:
When we took the picture of the scope, that was just one base station. However, our full setup uses two base stations.
USB serial has been properly set up. We presume this because we're able to communicate with the device in config and debug modes. Also, a simple Teensy sketch was able to communicate over serial just fine using the same board.
The device seems to be functioning fully, only code doesn't recognise pulses. We configured the base station geometry with data acquired from the SteamVR setup, though even with bogus geometry, I would think it would at least report *some* data.
One more thing; we ran a test sketch to see if the pin was reading any input from the amplifier at all, and it does. When we cover the sensor, the readings stop, as expected.

Any ideas?

ashtuchkin, 2017-04-27:
Hmm, probably next step for debugging this is to go to debug mode and look
whether pulses are actually identified. Can you go into debug mode and
issue smth like "sensor0 pulses show"?

More info
https://github.com/ashtuchkin/vive-diy-position-sensor/blob/docs/docs/manual.md

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

SquawkBirdies, 2017-04-28:
We tried using the debug command to show the pulses but it does not show anything. So, we tried installing another script to make sure that the signal was actually getting to D12. That program shows that the pulses are detectable from the Teensy.

Thank you for your help

ashtuchkin, 2017-04-28:
So it seems InputCmp is not seeing the pulses.. are you using the alpha2
release or compile master? Alpha2 should be more stable

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

GameFaceLabs, 2017-04-28:
Can you recommend some lenses that can be used over the ir sensors so as to embed the ir sensors inside a device?

ashtuchkin, 2017-04-29:
No, sorry, I haven't experimented with lenses in this project.

--
Alexander Shtuchkin

On Fri, Apr 28, 2017 at 2:06 PM, GameFaceLabs <notifications@github.com>
wrote:

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

SquawkBirdies, 2017-05-01:
I have tried both compiling the current version and using the Alpha2 release. For some reason, the program does not respond to serial commands when I use Alpha2. I can get a serial console when I flash the file that I compiled, but the sensor does not seem to detect the pulses.

If the code was able to see the pulses but could not properly interpret them, how would it interact? Would it end up not showing anything when I type "sensor0 pulses show"?

Thank you for your help.

ashtuchkin, 2017-05-01:
Alpha2 is less flexible than master wrt line endings - can you check your terminal is sending '\n' when you press enter?

`sensor0 pulses show` should show raw pulses - at this point in pipeline they are not classified/interpreted yet. The absence of pulses means we're not registering any.

unonu, 2017-05-01:
tl;dr `pulses` shows no pulses counted, but the Teensy definitely sees edges on the pin (pin 12, verified by another sketch,) but this is all using master, so we'll retry using alpha2.

I don't have the device In front of me right now, but we tried `sensor0 pulses count` before and it always counts 0. Consequently, `show` shows nothing. This was using master. Whenever I try to use the alpha2 release, it fails to flash (I'm using tycmd, Linux 4.9, ubuntu 16.04 based distro.) Squawk was able to get it flashed before from windows, so I guess we'll retry the release instead of master. I do find it odd, however, that the `pulses` command shows nothing even if it is supposed to show raw pulses received. Whereas the basic sketch that we run does see the pulses. I double checked your comparator setup in the interest of thoroughness and it seems fine (as expected.) So I wonder where the break down is.

jrobe, 2017-05-08:
I'm having the same issue with a teensy 3.2 - we're getting a good output on the scope, and in all reality it should be getting pulses - but it just seems like the teensy isn't recognizing them. Do you have any tips? I'd be willing to go through any debugging steps that you'd provide - we're trying to get this working for a NASA competition.

jrobe, 2017-05-16:
Update - I went to the v0.1 tag, and it worked great, I'm assuming there's something wrong with the multiple board/teensy versions support in the latest version, haven't had time to look further.

ashtuchkin, 2017-05-21:
Ok, I re-checked the master branch today and indeed there was a bug with the pulse input node. I pushed a fix and checked that the current master is now working fine on my teensy. Let me know if it fixes your problem as well.

jrobe, 2017-05-21:
That fixed it! Getting good position data from the sensors now. Thanks for that - thought I was going crazy until 0.1 worked.

ashtuchkin, 2017-05-27:
Great! Happy to hear that

Closed 2017-05-27.

Thread 25 (2017-05-08):

BPV22NF Photodiode angle of half sensitivity 60 instead of 120 deg?

DonnyVerduijn, 2017-05-08:
We ordered all the components to replicate the board, but the specification of the BPV22NF photodiode explains that the angle of half sensitivity is not 120 degrees, and instead 60 degrees. Should we use more than three in an array?

ashtuchkin, 2017-05-08:
AFAIK, it's 60 degrees in each direction, 120 total.

I used 3 of them and they covered the whole hemisphere without problems.

--
Alexander Shtuchkin

On Mon, May 8, 2017 at 7:16 AM, Donny Verduijn <notifications@github.com>
wrote:

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

Closed 2017-05-10.

Thread 26 (2017-05-15):

I have a question about the pulse of END circle

segatecm, 2017-05-15:
I had read the doc of the pules detail. I have question about the Circle.
The End Pules length do not be wrote on it. I confused with that because it will connected with the new begin pules of THE NEXT CIRCLE.
Then there are only two pules can be seen on Oscilloscope but three.
So please tell me how to check the end pules of ONE CIRCLE.
Thanks for your great job.

ashtuchkin, 2017-05-16:
Hey,

I assume you're talking about a cycle, not a circle.

Each cycle has 3 pulses: sync pulse from station A, sync pulse from station
B and a sweeping pulse from one of them. There is no "end pulse" in a
cycle. Each cycle has fixed length - 8.333ms and they go one after another,
so there's no need for an end pulse.

Did I answer your question? If not, could you draw a picture of what you're
trying to ask?

--
Alexander Shtuchkin

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

segatecm, 2017-05-17:
Yes , It's a cycle, not a CIRCLE. My mistake.
Thanks for your reply. I understand 3 pluses now.

And i have one question, how can i confirm the sweeping pulse send by A or B?

ashtuchkin, 2017-05-17:
I have more info about it in the readme.md, but the short version is using
the length of the sync pulses - if first sync pulse is shorter than second,
then the sweeping pulse is from A, else B.

On May 17, 2017 8:17 AM, "segatecm" <notifications@github.com> wrote:

Yes , It's a cycle, not a CIRCLE. My mistake.
Thanks for your reply. I understand 3 pluses now.

And i have one question, how can i confirm the sweeping pulse send by A or
B?

—
You are receiving this because you commented.

Reply to this email directly, view it on GitHub
<https://github.com/ashtuchkin/vive-diy-position-sensor/issues/26#issuecomment-302123542>,
or mute the thread
<https://github.com/notifications/unsubscribe-auth/AAmVHbYbALjZmnfgWSsBMTIIFuTnG3INks5r6w9wgaJpZM4NbZl_>
.

segatecm, 2017-05-18:
Thanks ashtuchkin! It's a simple way to decode Sync Pulse.

i read the [Light Emissions paper](https://github.com/nairol/LighthouseRedox/blob/master/docs/Light%20Emissions.md) from your readme.md. i still have questions about the define  of Pulse Length.

There are three states, skip, data and axis.
the axis bit equal 0 means horizontally or vertically ?
the skip bit equal 1 means the cycle must be aborted and sweeping value is invalid?

and the last question,the length(us) how to convert length(ticks)?

mwturvey, 2017-05-18:
Ticks would be the number of clock cycles given a 48Mhz clock.  The only thing special about 48Mhz is that it's the sampling frequency on the actual Vive hardware (i.e. Vive controllers, Vive tracker, and the hmd).  Also, fyi, the ticks value in that table is more precise than the time, which is an approximation.

segatecm, 2017-05-18:
Thanks mwturvey. Then can i use an arduino to sample the pulse? is it fast enough?

ashtuchkin, 2017-05-18:
Axis=0 is horizontal. 1 vertical.
Skip=0 means the same base station as giving this sync pulse will also
generate sweep pulse for this cycle. 1 means the other base station is
generating sweep pulse.

Remember, each cycle have 2 sync pulses, one from each station. Exactly one
of them will have skip=0, another - skip=1. This is how you determine which
base station is emitting the sweep pulse.

Back to your question about Arduino - it's probably possible using hardware
timers, but might be hard. Also, in my experience you need ~1 microsecond
timing precision to get 1-2 mm position accuracy.

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

mwturvey, 2017-05-18:
Allan Yates, who developed the lighthouse hardware made an interesting comment about using an Arduino last summer.
https://mobile.twitter.com/vk2zay/status/746917256093806594
I'd think you could get a single sensor to read alright on an Arduino Uno using hardware interrupts, but it would require some creative coding, I imagine.  Regular digitalread calls wouldn't get you close.
I was able to get an Arduino Due to do a pretty good job of reading 6 sensors at a time, and it could probably have scaled to twice that, easily.

segatecm, 2017-05-18:
Thanks ashtuchkin and mwturvey.I will do my receiver now!

segatecm, 2017-05-20:
Hi everyone ,i use the arduino decode the sweep value!!! and copy some values here:

Date Type:
1 - 3: Pulse length(µs)
4: sweep Pulse length - 4000 (µs)

64	126	6	-38
75	117	6	-806
64	107	6	-18
74	137	6	-826
127	80	9	-486
137	95	7	-753
64	106	6	-17
75	137	6	-825
128	72	8	-473
137	96	7	-754
85	127	6	-37
95	117	6	-803
64	127	6	-36
74	116	6	-803
106	85	8	-486
116	75	7	-732
64	106	6	-13
95	117	6	-804

i am so confused about the values. for example, i copy two lines value, and translate them to bits
64	127	6	-34
64	106	6	-13

bit vales here: (skip data axis)
 (0 0 0)   (1 1 0)
 (0 0 0)   (1 0 0)

from the values, look like the sweep pulse come from same station, but why the angle values are different? Which value is right?

ashtuchkin, 2017-05-21:
Looks like you're missing some cycles here. In a working two-station system, cycles should always come in this order, using your notation of (skip data axis):
```
(0 x 0) (1 x 0)
(0 x 1) (1 x 1)
(1 x 0) (0 x 0)
(1 x 1) (0 x 1)
.. repeat ..
```

Back to your question about different angles for the same base station - looks like your determination of start/end time is inaccurate. It could be the case if you use interrupt handlers to get time on pulse start (or end). They can be delayed by several dozen microseconds depending on other stuff happening on the microcontroller.

segatecm, 2017-05-22:
Learned from your posts, i check my data,

L1: 64	127	6	-34
L2: 64	106	6	-13
Compare the two lines.
i don't understand why the L1's second pulse larger than the L2's, but its sweeping time is smaller than the L2's ?
If the error data caused by microcontroller's delay, the L1's sweeping time must big then -13.

When the 127 translate to bits, it means (1 1 0), and the middle 1 means the 'data' bit is 1.

and the description say:
The data bits of consecutive sync pulses of a base station concatenated together yield a data structure called OOTX Frame.

And the OOTX Frame can not be used, so. i think i  this line must be droped.
L1: 64	127	6	-34

i don't know if i'm right, so please give same help!

ashtuchkin, 2017-05-22:
OOTX data is not really useful and you can ignore the data bit, but that
doesn't mean you should skip this cycle as it gives you the timing/angle
data.

In general the length of the sweep pulse shouldn't matter - it depends on
too many factors. What matters is the period of time between the center of
sweeping pulse and corresponding base station's sync pulse start. This will
give you the angle.

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

Closed 2021-07-06.

Thread 27 (2017-05-18):

No pulses detected. 50mV max signal voltage?

DonnyVerduijn, 2017-05-18:
After replicating the circuit, i found out that the BPV22NF operational amplifier does not amplify the signal towards the interrupt treshold of the teensy (3.3V). the TLV2462IP pulses are 50mV on the oscilloscope. How should i proceed?

ashtuchkin, 2017-05-18:
You can probably play with the amplification factor of the second opamp by
using an adjustable resistor in the feedback line.. currently it's set to
around 16.
Otherwise it's hard to say without inspecting the schematic

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

DonnyVerduijn, 2017-05-19:
I can confirm that the pulses are being recognized using a simple digitalread(high) conditional test, but the pulses are still not recognized using the build?

DonnyVerduijn, 2017-05-19:
I assume only the sensor0 configuration is mandatory in order to debug the pulses with sensor0 pulses show/count? I tried to use different treshold values, but nothing works. Could it be that something else is mandatory to in order to recognize the pulses?

sensor0 pin 12 positive cmp 20

ashtuchkin, 2017-05-19:
Do you use version 1.0alpha-2 ? I have some bug reports for the current
master, maybe rolling back to alpha2 can help

Yep, only sensor0 is necessary. Double-check polarity (ts3633 is negative,
others positive)

On May 19, 2017 7:51 AM, "Donny Verduijn" <notifications@github.com> wrote:

I assume only the sensor0 configuration is mandatory in order to debug the
pulses with sensor0 pulses show/count? I tried to use different treshold
values, but nothing works. Could it be that something else is mandatory to
in order to recognize the pulses?

sensor0 pin 12 positive cmp 20

—
You are receiving this because you commented.

Reply to this email directly, view it on GitHub
<https://github.com/ashtuchkin/vive-diy-position-sensor/issues/27#issuecomment-302724164>,
or mute the thread
<https://github.com/notifications/unsubscribe-auth/AAmVHbd5K4li158WMOe8MqCBWSzj6DD1ks5r7axxgaJpZM4NfUmI>
.

ashtuchkin, 2017-05-21:
Note, I fixed a bug with getting the pulses in a recent commit, so you could try the master branch. Let me know if it works.

ichingxs4all, 2017-05-21:
I'm getting pulses now with the bug fix . Used ' sensor0 pulses show'  to see them.

Pulse0:
sensor 0, time 442377561us, len 30 |
sensor 0, time 442377596us, len 15 |
sensor 0, time 442377621us, len 40 |
sensor 0, time 442377669us, len 3 |
sensor 0, time 442377677us, len 9 |
sensor 0, time 442379290us, len 118 |
sensor 0, time 442382085us, len 86 |
sensor 0, time 442387627us, len 65 |
sensor 0, time 442390417us, len 98 |
sensor 0, time 442393766us, len 1 |
sensor 0, time 442394199us, len 1 |
sensor 0, time 442394222us, len 17 |
sensor 0, time 442394249us, len 25 |
sensor 0, time 442394288us, len 39 |
sensor 0, time 442394329us, len 17 |
sensor 0, time 442394366us, len 7 (54 total)

Used this config with our own Lighthouse positions:

sensor0 pin 12 positive

base0 origin -1.292450 1.728665 1.322062 matrix 0.676982 0.270789 -0.684375 -0.017758 0.935596 0.352625 0.735786 -0.226567 0.638190
base1 origin 1.457454 1.714955 -1.283873 matrix -0.777161 -0.208656 0.593703 -0.012993 0.948550 0.316359 -0.629168 0.238148 -0.739887

object0 sensor0
stream0 position object0 > usb_serial
stream1 angles > usb_serial
serial1 57600
stream2 mavlink object0 ned 110 > serial1

 But I'm not getting position coordinates nor angles

OBJ0	44412	0
ANG0	45000	0
OBJ0	45000	0
ANG0	46000	0
OBJ0	46000	0
ANG0	47000	0
OBJ0	47000	0
ANG0	48000	0
OBJ0	48000	0
ANG0	49000	0
OBJ0	49000	0
ANG0	50000	0
OBJ0	50000	0
ANG0	51000	0

Am I doing something wrong here ?

ashtuchkin, 2017-05-21:
Great, now we have at least some visibility into what's going on inside. It
looks like there's a lot of noise in the pulses, try increasing the
comparator threshold (sensor0 pin 12 positive cmp 40). Regular threshold is
20 and corresponds to voltage 3v3/64*value.

Another thing to try is turn off the lights and try to play with sensor
rotation, so that you maximize base station signal.

On May 21, 2017 5:56 AM, "ichingxs4all" <notifications@github.com> wrote:

I'm getting pulses now with the bug fix . Used ' sensor0 pulses show' to
see them.

Pulse0:
sensor 0, time 442377561us, len 30 |
sensor 0, time 442377596us, len 15 |
sensor 0, time 442377621us, len 40 |
sensor 0, time 442377669us, len 3 |
sensor 0, time 442377677us, len 9 |
sensor 0, time 442379290us, len 118 |
sensor 0, time 442382085us, len 86 |
sensor 0, time 442387627us, len 65 |
sensor 0, time 442390417us, len 98 |
sensor 0, time 442393766us, len 1 |
sensor 0, time 442394199us, len 1 |
sensor 0, time 442394222us, len 17 |
sensor 0, time 442394249us, len 25 |
sensor 0, time 442394288us, len 39 |
sensor 0, time 442394329us, len 17 |
sensor 0, time 442394366us, len 7 (54 total)

Used this config with our own Lighthouse positions:

sensor0 pin 12 positive

base0 origin -1.292450 1.728665 1.322062 matrix 0.676982 0.270789 -0.684375
-0.017758 0.935596 0.352625 0.735786 -0.226567 0.638190
base1 origin 1.457454 1.714955 -1.283873 matrix -0.777161 -0.208656
0.593703 -0.012993 0.948550 0.316359 -0.629168 0.238148 -0.739887

object0 sensor0
stream0 position object0 > usb_serial
stream1 angles > usb_serial
serial1 57600
stream2 mavlink object0 ned 110 > serial1

But I'm not getting position coordinates nor angles

OBJ0 44412 0
ANG0 45000 0
OBJ0 45000 0
ANG0 46000 0
OBJ0 46000 0
ANG0 47000 0
OBJ0 47000 0
ANG0 48000 0
OBJ0 48000 0
ANG0 49000 0
OBJ0 49000 0
ANG0 50000 0
OBJ0 50000 0
ANG0 51000 0

Am I doing something wrong here ?

—
You are receiving this because you commented.

Reply to this email directly, view it on GitHub
<https://github.com/ashtuchkin/vive-diy-position-sensor/issues/27#issuecomment-302935111>,
or mute the thread
<https://github.com/notifications/unsubscribe-auth/AAmVHa76rM0lGV4vfjYTVBYKFZ3UwYHsks5r8DR8gaJpZM4NfUmI>
.

ichingxs4all, 2017-05-21:
Switched off all the lights.
I've got pretty good pulses on the scope ( see attachment). No noise visible.
When I move the sensor the pulses move nice horizontal without dropping level.

Tried several comparator levels. Best results with highest level 63.

Pulse0:
sensor 0, time 843870837us, len 90 |
sensor 0, time 843875213us, len 134 |
sensor 0, time 843879171us, len 78 |
sensor 0, time 843880830us, len 17 |
sensor 0, time 843880879us, len 18 |
sensor 0, time 843883545us, len 82 |
sensor 0, time 843887503us, len 114 |
sensor 0, time 843888772us, len 2 |
sensor 0, time 843891879us, len 72 |
sensor 0, time 843895653us, len 5 |
sensor 0, time 843895838us, len 101 |
sensor 0, time 843897497us, len 17 |
sensor 0, time 843897545us, len 18 |
sensor 0, time 843900212us, len 103 |
sensor 0, time 843904170us, len 113 |
sensor 0, time 843904286us, len 6 (22 total)

I don't get any PulseProcessor results nor Phase

PulseProcessor: fix 0, cycle id 0, num pulses 0 0 0 1, time from last pulse 4322
PulseProcessor: fix 0, cycle id 0, num pulses 0 0 0 1, time from last pulse 4323
PulseProcessor: fix 0, cycle id 0, num pulses 0 0 0 1, time from last pulse 4323
PulseProcessor: fix 0, cycle id 0, num pulses 0 0 0 1, time from last pulse 4323

CyclePhaseClassifier: fix 0, phase 0, pulse_base_len 62.500000, history 0x0, avg error 0.0 us
CyclePhaseClassifier: fix 0, phase 0, pulse_base_len 62.500000, history 0x0, avg error 0.0 us
CyclePhaseClassifier: fix 0, phase 0, pulse_base_len 62.500000, history 0x0, avg error 0.0 us
CyclePhaseClassifier: fix 0, phase 0, pulse_base_len 62.500000, history 0x0, avg error 0.0 us

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

ashtuchkin, 2017-05-22:
Wild guess - are you using 2 base stations or one? One-station
configuration is not supported for now.

The pulses list look weird, I don't see needed structure there. There
should be two large pulses (len 60-170) 400us apart, then small pulse (len
< 10), then repeat. Whole cycle should be 8333us long.

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

ichingxs4all, 2017-05-22:
I think I found the problem.....the Lighthouses where in A en B mode. I switched it to B and C ....and now it's working !

ANG0	152925	200	0.0484	-0.2834	0.4373	-0.7485
OBJ0	152925	1000	0.9759	-0.1205	-0.3831	1.0381
ANG0	152959	200	0.0485	-0.2831	0.4374	-0.7488
OBJ0	152959	1000	0.9763	-0.1201	-0.3841	1.0379
ANG0	152992	200	0.0488	-0.2832	0.4374	-0.7485
OBJ0	152992	1000	0.9756	-0.1197	-0.3840	1.0390
ANG0	153025	200	0.0484	-0.2833	0.4373	-0.7485
OBJ0	153025	1000	0.9761	-0.1204	-0.3832	1.0377
ANG0	153059	200	0.0485	-0.2832	0.4373	-0.7488
OBJ0	153059	1000	0.9762	-0.1204	-0.3840	1.0379
ANG0	153092	200	0.0487	-0.2832	0.4373	-0.7487
OBJ0	153092	1000	0.9759	-0.1201	-0.3841	1.0385
ANG0	153125	200	0.0485	-0.2832	0.4373	-0.7485
OBJ0	153125	1000	0.9759	-0.1199	-0.3835	1.0381
ANG0	153159	200	0.0487	-0.2832	0.4373	-0.7486
OBJ0	153159	1000	0.9758	-0.1200	-0.3840	1.0385
ANG0	153192	200	0.0484	-0.2831	0.4372	-0.7487
OBJ0	153192	1000	0.9764	-0.1203	-0.3838	1.0371
ANG0	153225	200	0.0486	-0.2831	0.4371	-0.7485
OBJ0	153225	1000	0.9758	-0.1198	-0.3839	1.0379
ANG0	153259	200	0.0486	-0.2833	0.4372	-0.7486
OBJ0	153259	1000	0.9758	-0.1204	-0.3837	1.0382

DonnyVerduijn, 2017-05-22:
Is there more information available regarding the configuration of the lighthouses? I assumed that these identifiers were only available for synchronization purposes, but they seem to influence the timing of the pulses if i understand right?. Maybe a good idea to document this in the readme.

ashtuchkin, 2017-05-22:
Wow thats great
 , congrats
:)

 T
he setup instructions for HTC Vive
 say
 that you need
 to use B and C modes.. Definitely the A mode will screw up the pulse
structure.

 I'll mention this in the readme.

On May 22, 2017 12:12 PM, "Donny Verduijn" <notifications@github.com> wrote:

Is there more information available regarding the configuration of the
lighthouses? I assumed that these identifiers were only available for
synchronization purposes, but they seem to influence the timing of the
pulses if i understand right?. Maybe a good idea to document this in the
readme.

—
You are receiving this because you commented.

Reply to this email directly, view it on GitHub
<https://github.com/ashtuchkin/vive-diy-position-sensor/issues/27#issuecomment-303193034>,
or mute the thread
<https://github.com/notifications/unsubscribe-auth/AAmVHbYWgXT6yZGd0c9EH8NjI25yBMc5ks5r8d4NgaJpZM4NfUmI>
.

Closed 2017-05-23.

Thread 28 (2017-05-22):

How to send the sensor-timing measurements in good way?

GameFaceLabs, 2017-05-22:
All timing-values always (no matter having gotten a trigger or not)?
Only triggered channels/sensors (e.g. filtering which is to be sent over to Unity).
Only max of xx sensors? (xx then decided upon by some criteria...)

ashtuchkin, 2017-05-23:
Not sure what trigger you mean here, could you write full questions please?

Max number of sensors depends on the microcontroller in use and method of
capturing pulses. Currently a teensy can serve 3 sensors using comparator
method, plus 6 more using hardware timers (in works now). Photon can serve
6 sensors if I remember correctly.

On May 22, 2017 12:07 PM, "GameFaceLabs" <notifications@github.com> wrote:

All timing-values always (no matter having gotten a trigger or not)?
Only triggered channels/sensors (e.g. filtering which is to be sent over to
Unity).
Only max of xx sensors? (xx then decided upon by some criteria...)

—
You are receiving this because you are subscribed to this thread.
Reply to this email directly, view it on GitHub
<https://github.com/ashtuchkin/vive-diy-position-sensor/issues/28>, or mute
the thread
<https://github.com/notifications/unsubscribe-auth/AAmVHWRyFrYpYLzzwHzLbNDGYCYzmiEVks5r8dzfgaJpZM4NiwlH>
.

Closed 2021-07-06.

Thread 30 (2017-07-22):

What happens when only one Lighthouse is in sight?

DanielArnett, 2017-07-22:
I need to get an accurate (<10cm error) position of one robot relative to another robot. I'm considering placing a Lighthouse on one robot, and this sensor on the other. I don't need depth, only X and Y.

Would this still give position within 10 cm even with only one lighthouse unit?

ashtuchkin, 2017-07-22:
 No, currently both base stations  must be in sight to get pulse
synchronization. This problem is technically solvable, just requiring a
rewrite of the synchronization module.

Having the above in mind, with just one base station the only thing you'll
be getting is two angles from the line along which the base station is
"looking". If depth is constant and base station is overlooking the area
where your robot is moving, then you should be able to convert it to XY
coordinates, but I'm not sure how you can do that with base station on
another robot.

Basically, if you have two robots moving in the same plane, then this won't
work at all.

--
Alexander Shtuchkin

On Sat, Jul 22, 2017 at 4:34 PM, DanielArnett <notifications@github.com>
wrote:

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

DanielArnett, 2017-07-23:
I appreciate your perspective, thank you. I don't need the robots position, there are other sensors for that. I'm looking for accurate _relative_ position between two robots, say for them to dock for instance. If I can get an accurate vector from one robot to another; then this sensor would be perfect. I don't care about coordinates as much as I do the angles between robots.

Any first thoughts on where I should look if I want to disable pulse synchronization and just use the pulses from one Lighthouse?

ashtuchkin, 2017-07-23:
O
 k, I trust you know what you're doing.

 This is
 the piece of sync algorithm that uses both stations to classify the cycle
phase depending on the large pulse widths:

https://github.com/ashtuchkin/vive-diy-position-sensor/blob/master/src/cycle_phase_classifier.cpp#L31

Having two stations simplifies the algorithm significantly, so I chose to
do it this way. It's possible to change it to work with only one base
station, but that would require rather significant rewrite of that module.
I'd assess it would take at least a week to do that, which I don't have atm.

--
Alexander Shtuchkin

On Sat, Jul 22, 2017 at 5:02 PM, DanielArnett <notifications@github.com>
wrote:

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

DanielArnett, 2017-07-23:
Okay, what about this for a workaround; how about if there were two lighthouses right next to each other; would that run and at least try to estimate position?

BoyHolthausen, 2017-07-24:
The lighthouse won't stay on if it detects its moving, so unless the robot is moving steadily at snail pace I would look for a different solution altogether. Your constraints are not too high (only azimuth and relatively low accuracy of 10cm), so you could consider making a rotating laser fan mechanism yourself.

Another reason to make your own version in this case is that the sync flashes would likely need 360 degrees coverage, but the basestations are limited to less than 180 degrees. Because you only need a single axis, you can get away with just a single flash at a constant interval however, no encoding/decoding of pulse lengths needed. Although, if multiple robots were equipped with a lighthouse-style tracking solution, you need to think about multiplexing. The easiest solution would be time division multiplexing, could use a cheap radio to communicate between robots who is allowed to emit light signals.

At this point however, it might be better to consider using a camera and OpenCV combined with some LEDs. The camera could be mounted on a servo to get 360 degree coverage, or you can use about 3 cameras with wide angle lenses.

DanielArnett, 2017-07-24:
Very interesting, thank you @BoyHolthausen! I was thinking the same thing using wide angle cameras and a visible laser. I'll think about this! Thanks

Closed 2021-07-06.

Thread 32 (2017-09-08):

Linux install issue

DanielArnett, 2017-09-08:
`make: *** No rule to make target `vive-diy-position-sensor-upload'.  Stop.`

Ubuntu 14.04, seems to be compiling properly.

DanielArnett, 2017-09-08:
I seem to be able to upload hex files with the [teensyduino uploader](https://www.pjrc.com/teensy/td_download.html), so I guess I'll stick to that for now.

ashtuchkin, 2017-09-10:
Check you have a `tyc` command-line uploader (see https://github.com/Koromix/ty), placed into `/usr/local/bin/`. Regular teensyduino uploader works as well, yep!

Closed 2017-09-10.

Thread 33 (2017-09-08):

Blinking Orange Light

DanielArnett, 2017-09-08:
I have the board assembled as shown, code built, and uploaded via the [teensyduino](https://www.pjrc.com/teensy/td_download.html) uploader but it is slowly blinking an orange light, and not outputting any serial information as expected. Any idea what it's doing, or what I could try to get it working? Really excited to experiment with this project!

ashtuchkin, 2017-09-10:
You have to configure it first, using serial connection. Refer to the manual (in works for now): https://github.com/ashtuchkin/vive-diy-position-sensor/blob/docs/docs/manual.md

SamaliLiyanage, 2018-06-25:
Hi,
I don't really understand how I could switch to the different mode i.e. Configuration mode, Debug mode etc etc

Closed 2021-07-06.

Thread 34 (2017-09-09):

Length of sensed sync pulses gets longer the closer you get to the Lighthouse.

solinvictus21, 2017-09-09:
I've adapted your circuit for my project, and while getting everything pulled together (months of work so far), I believe I have uncovered a slight flaw (or at least a shortcoming) in the circuit design. The closer the sensor gets to the lighthouse, the sensed timing of the sync pulses gets longer and longer than they should be. You can reproduce the extreme end of this behavior by putting the sensor within about a foot or less of the lighthouse, where the sensed sync pulses for even the shortest syncs (~3000 ticks) stretch beyond the range of what you should get for any of the pulses from Lighthouse station A (over ~5000 ticks).

If you have your base station mounted up high, this probably won't be a problem. My Lighthouse is mounted about waist-high and pointed toward the floor (building tiny robots that only move around on the floor) and when the robot gets within less than about 1.5-1.75 meters from the Lighthouse, the problem is enough that it starts causing the software to get confused about which sync pulses are which.

My initial suspicion is that the cap on the high pass filter is too large, causing the end of the sync pulse to stretch out as more and more light from the sync pulse comes through. I'm going to mess around with switching up the RC values for the high pass filter to see if it gets better or worse, starting by using a 4.7µF cap and a 100k resistor on the high pass filter instead of a 10µF cap and 47k resistor, but figured I'd file an issue in case you have any further insight into how to address it.

ashtuchkin, 2017-09-10:
Hey, I can see how it can happen, yes. The software compensates for it, though. Basically I always treat sync pulse length as relative to other sync pulses, not absolute value. Within several cycles the program should be able to adjust.

All in all, I recommend using something more production-ready as a sensor, like TS3633 modules.

I'm also open to any suggestions about how to make the DIY sensor better - I'm not a pro at electrical engineering and might have messed up something there :)

solinvictus21, 2017-09-10:
Nothing for production. Just making tiny robots that need localized positioning. I looked into the TS3633 modules, but I'm unsure if I can solder the WLCSP package it comes in. Like you, I'm also not an electrical engineer and I'm relatively new at soldering. I am now able to solder down to 0603 components on pre-printed boards, which is what I use for the PCB I had printed based around your schematic (though doubled to use a quad op-amp for two diode inputs). I'm going to see if I can just get better accuracy for the sync pulses by tweaking this schematic a bit before I try another route.

solinvictus21, 2017-09-15:
Update: The problem is unrelated to the R-C ratio of the high pass filter. Switching the values as described above had no effect. However, I've confirmed that the problem is actually the TIA feeback capacitor, but I haven't decided if it's too large or too small as yet. I confirmed this by removing the feedback cap entirely and the sensed sync pulse lengths are significantly more stable, but without the feedback cap, there is too much signal noise, creating many "dead spots" at various distances and angle offsets from the center of the lighthouse. This leads me to believe that the feedback cap needs to be smaller, though it's still possible the problem is caused by overshoot due to too small of a cap. I'm going to order some 2.2pf and a 10pf caps and test each one and will post what I find as an update here.

ashtuchkin, 2017-09-15:
 Very interesting, thanks for updating this thread!

--
Alexander Shtuchkin

On Fri, Sep 15, 2017 at 10:14 AM, Kyle Davis <notifications@github.com>
wrote:

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

solinvictus21, 2017-09-15:
No problem. I have another possible lead based on an examination of [a very similar schematic](https://trmm.net/Lighthouse). If you look about halfway down that linked page, you'll see a lighthouse sensor schematic that looks much like yours with a notable exception. It, too, uses a TIA into a high-pass filter into a non-inverting amp. It uses a different photodiode, though I checked the datasheets of both and they are largely similar (BPW34 is actually even a bit faster), and some of the numerics are suspiciously different such as the size of the TIA feedback resistor and the amount of gain in the last stage.

But the **interesting** part is the voltage divider on the front end. That lead me to do some reading, which lead me to [this description of the use of op-amps](http://www.radio-electronics.com/info/circuits/opamp_non_inverting/op_amp_non-inverting.php). In particular, note this quote in the last paragraph entitled "Non-inverting amplifier using single supply".

"To enable the op amp to run with just one power rail, the positive and negative rails have to be simulated by operating the amplifier half way between the rail and ground, and ensuring the decoupling is sufficient in all the required areas. This is often referred to as a virtual ground technique."

See what I mean? Interesting.

solinvictus21, 2017-09-28:
Yes! I have good news. After two weeks of experimenting (and becoming Digikey's best customer), I've come up with a new schematic that maintains extremely good timings that stay within the sync pulse timing windows across a much broader range and even provide better more consistent sweep pulses. Initial testing with my own software showed the sweep pulse timings staying within about 20 ticks at 48MHz when standing perfectly still, and that remaining drift is likely software-related.

The key was indeed to use a floating ground approach as described in the article I linked above, so I had to add an additional 5 passives to the schematic to create a ground isolation at 1.65v (half the 3.3v input supplied to the op-amps) and tweaked most of the numbers of the rest of the passives as a result to fit that portion of the circuit. It also required pulling a slightly different trick to amplify the signal in the 3rd phase of the circuit, which you'll see soon because after I get a chance to see if I can tweak it even further, I'm going to clone your repository and submit a PR with the new schematic.

solinvictus21, 2017-10-05:
I have the update for you. Rather than cloning the repository and updating the schematic directly, I'm just going to provide the schematic diagram for you via imgur. If you want the original Autodesk Eagle files, just let me know.

https://imgur.com/gallery/2KqbT

This schematic is actually a dual-diode detector so that I can determine orientation along a 2D plane, but you could easily halve it and swap out the op-amp if all you need is local position. This schematic is actually something of a mashup with the schematic mentioned here:

https://trmm.net/Lighthouse

However, I've done a TON of experimenting to improve sensitivity, reduce noise, and increase responsiveness. Here are the important changes to note with the linked schematic I'm providing:

1) This schematic uses a voltage divider at half of VCC to provide an A/C endpoint for the diode to both pull from and drain to, as recommended by the article linked above. This provided better responsiveness at distances closer to the lighthouse, but experimentation lead me to find further changes described below.

2) I eventually found that the BPC22NF diode was too slow, particularly in the trailing edge detection. I have swapped it out for the BPW34FA. Any version of the BPW34 will probably do, though I'd stick with versions that include the IR filter to reduce background noise.

3) I reduced the feedback capacitance in the TIA from 5pF to 2.2pF. I experimented with a range of capacitance values and found that 2.2pF was the best trade-off between responsiveness and reducing noise and ringing in the circuit.

4) I greatly increased the range of the high-pass filter via use of an 4.7nF/18k RC combo. I originally found that the size of the capacitor in this RC combo significantly affects responsiveness of the circuit when I first swapped the 10nF/47k resistor combo in your schematic with a 4.7nF/100k resistor combo. But I still found the circuit to be a little noisy at the 338Hz cutoff, so I increased the size of the filter until the noise went away. 4.7nF/27k was *almost* good enough, but is worse at farther distances, so I landed on 4.7nF/18k.

5) The final stage of amplification required larger gain, probably owing to the fact that the diode is now at half the voltage of the op-amp supply. Experimentation lead me to the gain you see in the schematic.

With these changes, the trailing and falling edges of the sensed sync pulse are now within the desired range up to within about a foot of the lighthouse, which is good enough for me. I still see some ringing in the circuit at close distances which I will likely try to optimize out in the future, but noise is greatly reduced and the timing of the sweep pulse is quite a bit more accurate.

If you have any questions, just let me know.

modulab, 2018-03-18:
Hi @solinvictus21 , nice circuit ! would you share the code for the two sensor implementation?

solinvictus21, 2018-03-18:
Certainly. I’ve since published all source code and 3 D models and everything else for my entire project. You’d be mostly interested in the source code in LighthouseSensor.cpp.

https://github.com/solinvictus21/Zippies

modulab, 2018-03-18:
@solinvictus21 wow! This is more or less the same thing that I was trying to make. Nice job man!

solinvictus21, 2018-03-19:
Excellent! Please join me on my project. It'd be great to have another set of hands working on it. It's taken me a year of iteration, mostly on the Lighthouse circuit hardware and 3D models, to get to the point I'm at now. I now have accurate positioning info from a single Lighthouse. Mostly focused on the PID models to make it do line following now. Send me a PM and I'll give you my email address and send you some more photos of a fully-assembled bot and more details on how to build one.

Closed 2021-07-06.

Thread 35 (2017-10-25):

TeensyLC compatibility?

SkaveRat, 2017-10-25:
I have an LC lying around and am wondering if it's possible to make the code compatible with it.

I've done a fair bit of vive tracking stuff myself on the board and it should be possible, the compiled hex just isn't compatible.

I don't know enough about the platform and cmake to see what has to be changed to get an LC compatible hex. Can anyone help me out?

ashtuchkin, 2017-11-01:
Nah, TeensyLC would be pretty hard to support as it's a different architecture.

Closed 2017-11-01.

Thread 36 (2017-10-27):

Issue with instructions and firmware generated on a Mac.

MPardi, 2017-10-27:
Hi,

I'm having two issues following the instruction using Mac OS as the operating system platform.

First, the command "make vive-diy-position-sensor-upload" doesn't work, it's not even mentioned in as a rule in the make file. I was able to get firmware installed on the teensy using "tycmd upload", but this leads to the next issue.

Using the firmware generated by make, located in "build/platform-teensy/vive-diy-position-sensor.hex" I don't get any response from the serial monitor. No config menu pops up. I was able to use the .hex file included in your last release from February to some success, as that would generate a prompt and allow me to configure the firmware, but not the firmware generated by the lastest commit on GitHub. The reason I ask about the firmware generated on my end is because I need to do some reconfiguration of your code in order to get data to be sent over Serial1 of the Teensy, but any reconfiguration I do just gives me a firmware file that doesn't allow me to config.

Do you happen to have any experience with this issue?

Thanks!

ashtuchkin, 2017-11-01:
Hey Michael, sorry don't have a lot of spare time these days.

For ..-upload target to work, make sure you have a "tyc" executable in /usr/local/bin. You can get it here - https://github.com/Koromix/tytools. "tyc" is an old name of this utility, which looks like now is called "tycmd". Rename should probably help, but I haven't tried that.
The target is defined here: https://github.com/ashtuchkin/vive-diy-position-sensor/blob/master/platform-teensy/teensy-targets.cmake#L79

The configuration issue could be happening because of different line endings that your terminal is sending when you're pressing "Enter".. That'd be my guess.

In your email you're asking
> Also, going through your code, I noticed you mention the different Serial's found on the Teensy within your code, and the configuration command for setting up the firmware in the TY monitor mentions setting the stream output using "stream# angles > usb_serial". If I try to set it to "stream# angles > serial1" I get an error message. Is there anyway to make it output to that Serial line by default within your code, or should I implement that myself.

I actually had data output via a serial port 1, so it should be definitely supported. Have you tried the following configuration:

```
reset  # Reset all settings to clean state
sensor0 pin 12 positive  # update to whatever you have
base0 origin -1.528180 2.433750 -1.969390 matrix -0.841840 0.332160 -0.425400 -0.046900 0.740190 0.670760 0.537680 0.584630 -0.607540
base1 origin 1.718700 2.543170 0.725060 matrix 0.458350 -0.649590 0.606590 0.028970 0.693060 0.720300 -0.888300 -0.312580 0.336480
object0 sensor0
stream0 position object0 > usb_serial
stream1 angles > usb_serial
serial1 57600  # note you must initialize serial before use.
stream2 angles > serial1
```

I started writing a manual here https://github.com/ashtuchkin/vive-diy-position-sensor/blob/docs/docs/manual.md but never got to finish it.. maybe it'll help as well.

shigazy, 2017-12-25:
Also running into the same issue while setting up the initial configuration when building from the latest repo.

MPardi, 2018-03-08:
Hey, sorry I never replied, we actually got it working, but we weren't able to generate certain movements within out app we were developing. With the setting up and configuration, are you just measuring the distance between the sensors and the circuit at its initial position. We were basing it off a distance measured in centimeters, but have issues properly measuring rotational matrices in a real physical setting (obviously much easier if we were developing something in a game engine).

Anyway, wanted to thank you again for the assistance. The manual is helpful, so I may attempt to use that to perfect the configuration in for the purposes we're using the project for.

Thanks again!

Closed 2021-07-06.

Thread 37 (2017-12-12):

Not understanding how to setup software part.

timfrans, 2017-12-12:
Hi,

Currently I am trying to setup the software part of this project.
I am working with windows.
Currently I have setup 2 system variables:
- cmake=C:\Program Files\CMake\bin\cmake
- PLATFORM=teensy

I try to run CMake with the configurations you can find in the picture.
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

As you can see it gives an error.
I copied the ninja.exe file into the vive-diy-position-sensor. Actually I do not understand what to do with the ninja.exe

also, if i try to run `cmake -G Ninja .. -DPLATFORM=Teensy`, it gives me an error that the command cmake is not found.

I hope you can help me :)
thx!

# Edit:
I think I got it figured out with the system variables. When run the command `cmake -G Ninja .. -DPLATFORM=Teensy` it still fails.

**CMakeError.txt**
> Compiling the C compiler identification source file "CMakeCCompilerId.c" failed.
Compiler: C:/Program Files (x86)/GNU Tools ARM Embedded/6 2017-q2-update/bin/arm-none-eabi-gcc.exe
Build flags: -O2;-Wall;-ffunction-sections;-fdata-sections;-Wstack-usage=256;-mcpu=cortex-m4;-mthumb;-mfp16-format=ieee
Id flags:
The output was:
1
c:/program files (x86)/gnu tools arm embedded/6 2017-q2-update/bin/../lib/gcc/arm-none-eabi/6.3.1/../../../../arm-none-eabi/lib/thumb/v7e-m\libc.a(lib_a-exit.o): In function `exit':
exit.c:(.text.exit+0x16): undefined reference to `_exit'
collect2.exe: error: ld returned 1 exit status
Compiling the CXX compiler identification source file "CMakeCXXCompilerId.cpp" failed.
Compiler: C:/Program Files (x86)/GNU Tools ARM Embedded/6 2017-q2-update/bin/arm-none-eabi-g++.exe
Build flags: -O2;-Wall;-ffunction-sections;-fdata-sections;-Wstack-usage=256;-mcpu=cortex-m4;-mthumb;-mfp16-format=ieee;-fno-rtti;-fsingle-precision-constant;-Woverloaded-virtual
Id flags:
The output was:
1
c:/program files (x86)/gnu tools arm embedded/6 2017-q2-update/bin/../lib/gcc/arm-none-eabi/6.3.1/../../../../arm-none-eabi/lib/thumb/v7e-m\libc.a(lib_a-exit.o): In function `exit':
exit.c:(.text.exit+0x16): undefined reference to `_exit'
collect2.exe: error: ld returned 1 exit status
Determining if the C compiler works failed with the following output:
Change Dir: A:/hoge/17-18/ap vallet/vive-diy-position-sensor/build/CMakeFiles/CMakeTmp
Run Build Command:"A:/hoge/17-18/ap vallet/vive-diy-position-sensor/build/ninja.exe" "cmTC_b28c9"
[1/2] Building C object CMakeFiles/cmTC_b28c9.dir/testCCompiler.c.obj
[2/2] Linking C executable cmTC_b28c9
FAILED: cmTC_b28c9
cmd.exe /C "cd . && C:\PROGRA~2\GNUTOO~1\62017-~1\bin\AR19DD~1.EXE -O2 -Wall -ffunction-sections -fdata-sections -Wstack-usage=256 -mcpu=cortex-m4 -mthumb -mfp16-format=ieee  -O2 -Wl,--gc-sections,--relax,--defsym=__rtc_localtime=0 -mcpu=cortex-m4 -mthumb -mfp16-format=ieee -TA:/hoge/17-18/ap vallet/vive-diy-position-sensor/libs/cores/teensy3/mk20dx256.ld CMakeFiles/cmTC_b28c9.dir/testCCompiler.c.obj  -o cmTC_b28c9   && cd ."
AR19DD~1.EXE: error: vallet/vive-diy-position-sensor/libs/cores/teensy3/mk20dx256.ld: No such file or directory
ninja: build stopped: subcommand failed.

My OS is Windows and I use CMake 3.10.1.
Thx :)

jayaramanrp, 2019-05-27:
Add Cmake path to environmental variable.
try disabling the anti virus/ windows defender.
execute cmake -G Ninja .. -DPLATFORM=Teensy command in cmd in build folder.

Closed 2021-07-06.

Thread 38 (2017-12-25):

Multiple Sensor Inputs // Switching to FTM sensor

shigazy, 2017-12-25:
Hey!

Code's working great! Thank you! - Hoping to get multiple sensors working and outputting data in the serial. I can see the functionality in the config mode for switching Pins and assigning them to sensors/objects but trying to assign new pins gives a "CMP0" already assigned to "Pin X" error. Is there a way to assign inputs through config or would it have to be hard coded?

Also - same question for switching from CMP to FTM - is the option unavailable through config? If so, what's the best way to assign it manually in the code?

Thank you so much! It's been a huge help to get this to work for our project

Thread 39 (2018-01-17):

Arduino

bridger35, 2018-01-17:
Is there a way to change this to Arduino?

ashtuchkin, 2018-01-17:
Probably yes, for ARM-based Arduinos like Duo. But you'll have to create a
new "platform" directory with all the wiring specific to that controller.

--
Alexander Shtuchkin

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

bridger35, 2018-01-17:
Thanks, I will look into that

Aaryan90, 2018-06-01:
What advantage do ARM-based microcontrollers have over others (say ESP 8266, Arduino) for this specific implementation? I am looking to port this functionality into nrf52832 BLE chip.

ashtuchkin, 2018-06-03:
Nice! I'm accepting pull requests if you're willing to share the code.

Wrt advantages - none really, except maybe that arm is generally faster
than arduinos and I worried that arduinos won't be fast enough. I also had
more experience with arm, so chose it as the target.

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

jayaramanrp, 2019-06-04:
where we have to modify the code inorder to add IMU in this project?

Closed 2018-01-17.

Thread 40 (2018-01-17):

Circuit layout

bridger35, 2018-01-17:
I'm fairly new and was wondering if anyone could give me a guide on which holes to place what wires through, preferably accompanied with pictures.

bridger35, 2018-01-17:
Maybe even a walkthrough video

ashtuchkin, 2018-01-18:
Sorry, the board pictures in the readme is all I have for now. It should be
pretty straightforward to use that, plus schematics to reproduce the board.

--
Alexander Shtuchkin

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

bridger35, 2018-01-18:
What about the wire going from i 10 to g6 is that just plain metal

bridger35, 2018-01-18:
and 13 H to 9 H is that a double resistor and should the ends of the resistors be twisted

ashtuchkin, 2018-01-18:
Yes yes and yes

One other option you have if you don't want to risk is to buy a sensor
TS3633-CM1 for like $10 and be sure it works.

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

modulab, 2018-01-30:
Hi @ashtuchkin. can you update the circuit diagram with the pin number from the TLV2462IP? i think you are using it reversed. thank you

ashtuchkin, 2019-12-09:
sorry don't have time for that, but willing to accept a PR

Closed 2019-12-09.

Thread 42 (2018-01-28):

Working for Teensy 3.6

mattgil23, 2018-01-28:
I wanted to know if you considered using the Teensy 3.6 for the project. I love what you did and I'd like to do it with the CM1 sensors from triad and the 3.6 so I can have 6DOF tracking.

alexhgian, 2018-02-09:
Also wondering of a Teensy-LC will work trying to see how low cost I can make this build.

kajep09, 2018-03-21:
It does work on the Teensy 3.6 with a few modifications. There is already a (closed) issue on the topic
https://github.com/ashtuchkin/vive-diy-position-sensor/issues/14

Closed 2019-12-09.

Thread 43 (2018-01-30):

Is ESP8266 a good idea?

modulab, 2018-01-30:
Do you think running the code on a ESP82266 or ESP32 would be a good idea ? The processor is almost twice as fast and it has more intrerup pins. And having direct wifi to broadcast the results it's priceless. What do you think?
thanks, Paul

ashtuchkin, 2018-01-30:
If it has a good, stable hi-res timer, you should be good to go. You'll
have to reimplement the platform layer though, to access the hardware.

If you're interested in wifi, Photon board is also an option - it's one of
the already supported platforms and I had success sending location data
wirelessly with it.

--
Alexander Shtuchkin

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

Closed 2019-12-09.

Thread 44 (2018-02-09):

Problem with the Particle Photon platform

Wyldix, 2018-02-09:
I've been successfully using your program for a Teensy 3.6 platform and everything works fine. I tried to build the firmware for the Particle photon platform but it doesn't compile.  The compiler shows an error at the "make all" command of the make file. As far as I know you did not provide any documentation about the Particle photon platform. Would it be possible to have some explications about the command you used to build the firmware like you did for the Teensy?

Tanks, Olivier

thomasgauthier, 2018-02-16:
I had the same problem. Seems like it has to do with GCC. I was able to successfully compile it by downgrading gcc-arm-embedded from 7-2017-q4 to 5.4.

To do it on MacOS

```bash
brew cask uninstall --force gcc-arm-embedded
brew cask install https://raw.githubusercontent.com/caskroom/homebrew-cask/ed1b2f3a4182f8512dfe88102ed79b4deb770faa/Casks/gcc-arm-embedded.rb

mkdir build && cd build
cmake .. -DPLATFORM=Particle
make
```

Wyldix, 2018-02-16:
Thank you Thomas!

I was also having some errors when compiling the Particle firmware but i didn't try to downgrade GCC. I will try that! Thanks.

alexhgian, 2018-02-20:
I'm also have this issue with Ubuntu 17.10 on 5.4 and latest

Wyldix, 2018-03-19:
I tried again on W10 and Ubuntu 16.04 both with GCC 5.4 and it still didn't compile for the Particle platform. It works for Teensy. It's getting weird since it works on MacOS...

shwetankshrey, 2018-06-29:
Hi
Did anyone successfully compile the code for Particle Photon. If yes, could you please share how you did that? I am working with Linux and have tried it on MacOS as well. However it didn't compile for me even after downgrading. On Linux, the error I get is :
`make[3]: *** No rule to make target 'all'.  Stop.
platform-particle/CMakeFiles/sensor-firmware.dir/build.make:57: recipe for target 'platform-particle/CMakeFiles/sensor-firmware' failed
make[2]: *** [platform-particle/CMakeFiles/sensor-firmware] Error 2
CMakeFiles/Makefile2:121: recipe for target 'platform-particle/CMakeFiles/sensor-firmware.dir/all' failed
make[1]: *** [platform-particle/CMakeFiles/sensor-firmware.dir/all] Error 2
Makefile:83: recipe for target 'all' failed
make: *** [all] Error 2`

shwetankshrey, 2018-07-05:
@thomasgauthier @ashtuchkin Please help me out here. Thanks.

Thread 45 (2018-02-23):

Getting global position of sensor?

jackg0, 2018-02-23:
Hello,

Is there a simple way to get the global position of the sensor? I'm using the repository for a research project and the global position is necessary for my application. Any help would be greatly appreciated!

Thanks,
Jack

ashtuchkin, 2019-12-09:
The position will be relative to the base stations, the sensor doesn't have the means to get a global position.

Closed 2019-12-09.

Thread 46 (2018-03-13):

Start of second syncpulse is off(~17ms).

koen1993, 2018-03-13:
So i used the sensor board as shown, but wanted to process the signal by myself (via a esp32 DevKit v1).
Now when i read the time, the second syncpulse starts to late:

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

in this example, the second pulse start 16 ms to late, and i get this for every cycle (always off by around 17us), But the overalltime with 8332us is always on spott (within a 1us margin). Also processing the the pulse lenght of the two syncpulses, they are often off.
In this example, SP1: 1,0,0 SP2: 1,1,0 (skip, data, axis). This eror happens every 4-6 cycles in addition i occasionally get pulses which are longer than 135us(136-139).

Now coupled with the still correctly overall lenght, i am at a loss as to how to correct the SyncPulses, or where my Error lies. (If this does matter, Lighthouses Sync via cable(A, B).).

Edit: I still have no idea, why my data is off, but after if i correct the pulses which are a bit longer down to 135us, transfer this to bits (skip data axis), and substract 1 from this bits, i get correct Skip / Axis bit for 99% of the time

modulab, 2018-05-27:
can you post the code? are you using interrupts?

ashtuchkin, 2018-05-27:
My approach was to not assume there's exactly 400µs between the pulses and
just calculate distance from the laser pulse to the sync pulse of the same
station. That worked pretty well.

--
Alexander Shtuchkin

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

koen1993, 2018-06-20:
@modulab I checked everything thought, and also found another issue #34 there its stated that the problem lies in the sensorboard.
@ashtuchkin The Problem is rather which Station(the shorter Syncpulse), and which Axis is sending right now, but i changed it now with two simple tricks:
The longer syncpulse is the one which signals skip,
and by collecting 4 cycles(2 Syncs + Lasersweep), i can say first cycle for station 1 is hor and second cycle is vert (dont exactly remember which one comes first right now).

With that i think i consider this topic as closed? Its not exactly the solution but the workaround worked perfect.

Closed 2018-06-20.

Thread 47 (2018-03-24):

Sensor Power Consumption

robnewton, 2018-03-24:
Can anyone tell me the power consumption of the sensor without the teensy?

I am hoping to borrow this 360 deg IR sensor design for a system that does NOT use lighthouse base stations but instead a low speed TTL fan laser on a single axis. The sensor MCU and diodes must run on very low power and wake regularly to detect a laser sweep then sleep again.

ashtuchkin, 2018-03-26:
Sorry, I have no idea. You might want to consult datasheets of the mcu and
diodes.

--
Alexander Shtuchkin

On Sat, Mar 24, 2018 at 3:41 PM, Rob Newton <notifications@github.com>
wrote:

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

robnewton, 2018-03-26:
Yep I've been doing that but I was hoping someone could put a scope on theirs to give real world numbers before I built it myself. No worries though and thanks for the cool project.

rwender, 2019-12-09:
We (Triad Semiconductor), have a new sensor the TS4112 that integrates the photodiode and electronics into a single component. Regarding power, this part has three modes of operation. In "operation" or detection mode the part uses ~2.5mA based on SteamVR base station sweep rates. The part also has two sleep modes. In Sleep mode, the typical current drops to 0.5mA. In deep sleep mode, the worst case current is 0.15mA. The difference between the two sleep modes is the recovery time from sleep to "operational / detect" mode with deep sleep taking longer. We will have engineering samples of the TS4112 available in Feb '20.

Closed 2019-12-09.

Thread 49 (2018-05-28):

Integrating to custom project

maker-ja, 2018-05-28:
Hi people.

I am trying to integrate this code into a custom project. Basically, I wish to implement data acquisition from a 6 DOF inertial sensor in the same Teensy board that is running this code. I will have to enable I2C functionality for that. Further, I am looking to save data in a SD card which will require implementing SPI functionality.

I am new to embedded C and can't seem to understand the code structure, program flow. Could someone please elaborate on the same. TIA.

ashtuchkin, 2019-12-09:
Sorry I haven't had time to write on the code structure, this is a hobby project that I'm not actively developing anymore.

Closed 2019-12-09.

Thread 50 (2018-06-11):

Receiving sensor position data

HiruniNuwanthika, 2018-06-11:
Hi,
I have cloned your project, compiled and created the hex file. How can I get the sensor position details in to the command line?
Teensy_loader_Cli is not working on my PC.
I'm working on windows 10 and I have used Teensy 3.2 same as you.

Thank you!!!

ashtuchkin, 2018-06-11:
Hey Hiruni, does the official uploader app work for you?
https://www.pjrc.com/teensy/loader.html

Try to load some other program first, see if it works.

--
Alexander Shtuchkin

On Mon, Jun 11, 2018 at 7:08 AM, HiruniNuwanthika <notifications@github.com>
wrote:

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

HiruniNuwanthika, 2018-06-12:
Hi Alexander,
Thank you for answering..

I have tried few programs with Teensy loader as well as the Teensyduino.
Blink _fast and Blink_slow programs with Teensy loader
Simple program with a photo diode circuit using Teensyuino.

What should I do to run a program in teensy_loader_cli?
Can you please help me?

Thank you!!!

jayaramanrp, 2019-05-27:
how did you create .hex file?

HiruniNuwanthika, 2019-05-27:
yes... It worked for me

On Mon, May 27, 2019 at 3:26 PM Jayaraman r p <notifications@github.com>
wrote:

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

luoxz-ai, 2022-02-17:
How to use tycmd in windows ?
How can I configure the module as you stated in https://github.com/ashtuchkin/vive-diy-position-sensor/blob/docs/docs/manual.md ?

luoxz-ai, 2022-02-17:
Can the arduino serial port be able to view the debug output information?

Closed 2019-12-09.

Thread 51 (2018-06-16):

Steamvr compatibility.

Lightsteed, 2018-06-16:
Hi! If i build this device, will it be picked up as a tracker in steamvr and have its position be usable for things? Also,how would i get the data into the pc? Wirelss or usb (usb over ip) ? Thanks !

ashtuchkin, 2018-06-18:
> will it be picked up as a tracker in steamvr
no

it's a low-level tracker, you decide how you get the data to pc - depending
on the chip it can be usb, uart, wifi, etc.

--
Alexander Shtuchkin

On Sat, Jun 16, 2018 at 6:34 AM, Lightsteed <notifications@github.com>
wrote:

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

Lightsteed, 2018-06-20:
Okay but assuming i get the data to the pc, will it be detected in steamvr? Sorry if u already answered it i just want to be sure.

koen1993, 2018-07-11:
No.

Closed 2019-12-09.

Thread 53 (2018-06-25):

File to run for configurations

HiruniNuwanthika, 2018-06-25:
Hi,

Can you give more details on which file to run to set the configurations mentioned in the link below?
https://github.com/ashtuchkin/vive-diy-position-sensor/blob/docs/docs/manual.md

koen1993, 2018-06-25:
Use [tytools](https://github.com/Koromix/tytools) (if i remember correctly the command should be 'tycmd monitor') with this you acces the teensy, to exit debug mode (in case you start in it) type '!' (this should put you in config mode).
than you can use the above linked commands in said config mode.

HiruniNuwanthika, 2018-06-25:
Thank you for your answer..
I have cloned the tytools project from  github. Any idea how to run the
tycmd?
I could get the Tycommander. But what I want is the Tycmd.

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

HiruniNuwanthika, 2018-06-25:
Thank you for your answer...

I used the command 'tycmd  monitor' and It started monitoring the teensy board. But when I type '!' it does not change and put me into config mode. How can I change configurations?

koen1993, 2018-06-26:
Usualy you start in config mode, you only need to type '!' if you are in debug mode. After starting 'tycmd monitor' press enter once, after it you should read either 'config>' or 'debug>' ... if you are in debug mode, `exit` it typing '!' if you are in config mode, well then you are where you want to be ...
Or do you have a different output when you press enter?
btw this is an example configuration i used. Thought you should your own Rotationmatrixes [(This might help you if you don't know how)](https://github.com/ashtuchkin/vive-diy-position-sensor-geometry-getter)
`
reset
sensor0 pin 12 positive
base0 origin -1.099456 2.181808 1.686393 matrix 0.775341 0.268522 -0.571613 -0.006164 0.908281 0.418314 0.631512 -0.320813 0.705883
base1 origin 1.467740 2.275151 -1.877902 matrix -0.730416 -0.392384 0.559041 -0.009979 0.824549 0.565703 -0.682930 0.407620 -0.606179
object0 sensor0
stream0 position object0 > usb_serial
stream1 angles > usb_serial
serial1 57600
stream2 mavlink object0 ned 110 > serial1
write
continue
o
`

HiruniNuwanthika, 2018-06-26:
Thank you very much for your support!!!!

HiruniNuwanthika, 2018-06-29:
I have done the configurations as given in your example. For base0 and base1 I have included base station data obtained for my room settings. But when I switch to the running mode, I get all values as zero. Then I tried 'geom0 show' in debug mode. It  also gave me
"pos 0.0000 0.0000 0.0000, dist 0.0000".  But I can not find the reason for not getting position data.  Can you please help me?

ashtuchkin, 2019-12-09:
Thanks @koen1993!

Closed 2019-12-09.

Thread 54 (2018-06-29):

Mismatch b/w coordinate axis mapping - real world and sensor values

maker-ja, 2018-06-29:
If we move the object in a particular axis wrt the ground and the light house, we get a change in all 3 axes, which is different in respect to the change given by the Vive controllers. As per our understanding there is a mismatch in the coordinate axes that unity uses and the one given by this repository. We could try to solve the problem by applying coordinate geometry on multiple points and find the shift and rotation in both coordinate spaces. Is there any other solution for the same? Please suggest a solution.

koen1993, 2018-07-11:
You are using the teensy? You used your own RotationMatrixes?(aka you configured the teensy) configuration and rotationmatrixes are referenced in issue #53

ashtuchkin, 2019-12-09:
I assume Unity applies it's own set of rotations/transformations, make sure you got them right. Otherwise I don't have a solution. It did work fine for me when I tried without additional rotations.

Closed 2019-12-09.

Thread 56 (2018-07-11):

Error compiling for a Photon board

shwetankshrey, 2018-07-11:
Hi

I am trying to compile the code for a Photon board. I have a 32 bit Ubuntu 14.04 setup with arm-none-eabi-gcc version 5.4.1 and CMake 3.2.2. I did the following :
`git clone https://github.com/ashtuchkin/vive-diy-position-sensor.git`
`cd vive-diy-position-sensor/`
`git submodule update --init`
`mkdir build`
`cd build`
`cmake .. -DPLATFORM=Particle`
`make`

The code starts building and target _sensor-core_ is built successfully. However for the next target _sensor-firmware_, I get an error as follows:
`Scanning dependencies of target sensor-firmware`
`make[3]: *** No rule to make target 'all'.  Stop.`
`make[2]: *** [platform-particle/CMakeFiles/sensor-firmware] Error 2`
`make[1]: *** [platform-particle/CMakeFiles/sensor-firmware.dir/all] Error 2`
`make: *** [all] Error 2`

I check and don't find an empty _particle-firmware_ in the libs directory. So I found the repository's Github URL mentioned in _platform-particle/CMakeLists.txt_ and manually clone it in that directory as follows:
`git clone https://github.com/ashtuchkin/spark-firmware.git particle-firmware`
`cd particle-firmware/`
`git checkout release/stable`
Note : There was a particle-firmware but it was empty so I deleted it and cloned this one again.

After running the make command again in the build directory, I get a new set of errors which I understand mostly to be issues related to not adhering to the C++14 standards. Some of the errors:
- `error: defaulted declaration 'constexpr TimeDelta& TimeDelta::operator=(const TimeDelta&) const'`
- `error: body of constexpr function 'constexpr uint32_t static_strlen(const char*)' not a return-statement`
- ` error: non-constant condition for static assertion`

I compare the _platform-particle/CMakeLists.txt_ and _platform-teensy/CMakeLists.txt_  and found that the Teensy CMake file contains a `set(CMAKE_CXX_STANDARD 14)` while there isn't any mention of a similar line in the Particle CMake file. I manually add the `set(CMAKE_CXX_STANDARD 14)` statement in _platform-particle/CMakeLists.txt_, remove the build directory and rebuild. **However, this is not making any differences and the make still fails with the same errors.**

I can go about the erroneous C++14 standard lines and make them compliant to earlier versions, but I do not think that would be a correct way to approach this error. I am not an expert on CMake or C++ and whatever I have been doing till now it just Googling and my intuition. However, there should be a proper solution to this. I went over through the issues and found that people have compiled the code for their Photon boards using Macs. I don't know how this could have happened but please help me out here. Thanks in advance.

ashtuchkin, 2018-07-11:
Have you tried it with CMake 3.5+, as described in prerequisites section
<https://github.com/ashtuchkin/vive-diy-position-sensor#installation-on-macos-linux>
?
--
Alexander Shtuchkin

On Wed, Jul 11, 2018 at 6:55 AM Shwetank Shrey <notifications@github.com>
wrote:

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

shwetankshrey, 2018-07-12:
Yes, I have tried with CMake 3.5.2 as well. It shows the same errors as above for me.

ashtuchkin, 2019-12-09:
Yeah I think you're right about your configuration not having a C++ 14 standard enabled. Maybe there's a difference between arm-none-eabi-gcc version 5.4.1 and the 5_4-2016q3 I was using? I don't have too much time trying to debug this, sorry.

Closed 2019-12-09.

Thread 57 (2018-07-29):

Issue with the setup; Teensy doesn't work.

Aaryan90, 2018-07-29:
I am going for a wireless solution for the same setup, my setup connects a 3.7V battery on the Vin of a Teensy 3.1 and then I route same power through the OpAmps as well. The Teensy doesn't power up in this case. When I remove the OpAmp ICs from the circuit, the Teensy begins to blink. I am not sure what is wrong with the setup here! Do suggest any corrective measures I can take to rectify the same!

koen1993, 2018-08-07:
I remember the SensorBoard having 5v input, so i would say not enough power, so do the obvious, and disconnect the SesnorBoard, Teensy now working? Proly not enough input. Still not working? Proly problem with the Teensy not the setup. (btw the vin pin should be the only pin capable of supplying the needed 5v on the Teensy 3.1 afaik)

ashtuchkin, 2019-12-09:
Yeah it's hard to say what's going on.

Closed 2019-12-09.

Thread 58 (2018-08-28):

values given by vive-diy-position-sensor-geometry-getter

HiruniNuwanthika, 2018-08-28:
What are the details included in the rotation matrix of each base station?

As I understood,
In https://github.com/ashtuchkin/vive-diy-position-sensor-geometry-getter it gives
First three values are the base station center points.
What I cannot understand is the next 6 values given. (values next to the word matrix)

Please explain it to me...
Thank you!

ashtuchkin, 2018-08-28:
It's the non-zero values of rotation matrix. A matrix is technically 3x3,
but the diagonal is zeros, so that leaves us with 6 numbers.
--
Alexander Shtuchkin

On Tue, Aug 28, 2018 at 12:49 PM HiruniNuwanthika <notifications@github.com>
wrote:

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

HiruniNuwanthika, 2018-08-29:
Thank you for your explanation. But it will be more helpful if  you can give me a precise answer.
 What is the rotation matrix? is it X,Y,Z coordinate positions?

Thank you!

ashtuchkin, 2018-08-29:
No, it's the rotation matrix - sines and cosines of corresponding angles. See https://en.wikipedia.org/wiki/Rotation_matrix#In_three_dimensions

I also see in the code that it expects 9 values there, sorry for confusion. 6 won't make it.

HiruniNuwanthika, 2018-08-30:
I understood it completely... Thank you!!!

HiruniNuwanthika, 2018-08-31:
According to my understanding,
The values that are finally printed on the terminal is fix value, x, y, z, distance between 2 lines.
What is considered as the center point of those given values?

Thank you!!!

ashtuchkin, 2018-09-02:
Not sure I understand the question.. xyz is the center. Distance between
the lines can be used to get a sense of accuracy of the position estimate
(although not directly).

On Fri, Aug 31, 2018, 02:57 HiruniNuwanthika <notifications@github.com>
wrote:

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

HiruniNuwanthika, 2018-09-04:
Thank you!!! I understood it...

Now I have another problem. Is there a method to track another set of three photodiodes? how should I do the configurations?
Thank you!!!

ashtuchkin, 2018-09-04:
If you want to track them as independent objects, then just add them to
your config like this:
```
<your base station config>
sensor1 pin 12 positive
object1 sensor1
stream1 position object1 > usb_serial

sensor2 pin 13 positive
object2 sensor2
stream2 position object2 > usb_serial
```

If, on the other hand, you want to track them as a single object, then that
is not supported, sorry.

On Tue, Sep 4, 2018, 04:57 HiruniNuwanthika <notifications@github.com>
wrote:

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

ashtuchkin, 2018-09-04:
If you want to track them as independent objects, then just add them to
your config like this:

```
<your base station config>

sensor1 pin 12 positive
object1 sensor1
stream1 position object1 > usb_serial

sensor2 pin 13 positive
object2 sensor2
stream2 position object2 > usb_serial

..same thing for third and fourth ones
```

If, on the other hand, you want to track them as a single object, then that is not supported, sorry.

HiruniNuwanthika, 2018-09-04:
I want to track them as independent objects.
Thank you  very much for your answer......

HiruniNuwanthika, 2018-09-13:
I tried to configure for another set of photodiodes as you have explained in https://github.com/ashtuchkin/vive-diy-position-sensor/issues/58#issuecomment-418426095.
But the following error occurred. "Invalid threshold level. Supported value: 0-63".
How can I solve the problem?

Thank you!!!

ashtuchkin, 2018-09-13:
This is where it's coming from
https://github.com/ashtuchkin/vive-diy-position-sensor/blob/master/src/input.cpp#L103

What's the config you're using?

jayaramanrp, 2019-06-14:
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

where to add the second independent object detail in the code?
it would be helpful, if you share some knowledge.

jayaramanrp, 2019-06-14:
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

got the answer:

open cmd (in windows) where TYtools are located.
enter into config mode by pressing "!"
then type the folowing :
reset
#enter the based station geometry (that you calculated) or you can find the default in settings in src/settings.cpp:17 to 24
 write
continue

-enjoy

Closed 2019-12-09.

Thread 60 (2018-09-25):

confused about normal verctor described by 'Position calculation in detail'

poaongithub, 2018-09-25:
Hi,
refer to left-hand coordinate and the illustration, the normal vector of the YZ plane is (0, cos(angle_hor), -sin(angle_hor)), rather than (0, cos(angle_hor), sin(angle_hor)),  Z axis value always negative, right? I don't know whether it's correct or not, thanks.

ashtuchkin, 2019-12-09:
that depends on the direction of rotation, the drawing is representing it backwards. In the code I use (0, cos(angle_hor), sin(angle_hor)).

Closed 2019-12-09.

Thread 62 (2018-10-13):

tyc monitor only giving 000000 as values not giving coordinates

rajattyagi134, 2018-10-13:
Or do you have a different output when you press enter?
btw this is an example configuration i used. Thought you should use your own Rotationmatrixes [(This might help you if you don't know how)](https://github.com/ashtuchkin/vive-diy-position-sensor-geometry-getter)

reset
sensor0 pin 12 positive
base0 origin -1.099456 2.181808 1.686393 matrix 0.775341 0.268522 -0.571613 -0.006164 0.908281 0.418314 0.631512 -0.320813 0.705883
base1 origin 1.467740 2.275151 -1.877902 matrix -0.730416 -0.392384 0.559041 -0.009979 0.824549 0.565703 -0.682930 0.407620 -0.606179
object0 sensor0
stream0 position object0 > usb_serial
stream1 angles > usb_serial
serial1 57600
stream2 mavlink object0 ned 110 > serial1
write
continue
o

ps: the 'o' param will throw you into the debug mode, but after configuration everything, you can get some outputs from there (check the command list you linked)

_Originally posted by @koen1993 in https://github.com/ashtuchkin/vive-diy-position-sensor/issues/53#issuecomment-400212234_

ashtuchkin, 2019-12-09:
not sure what's the issue here

Closed 2019-12-09.

Thread 63 (2019-01-23):

hello,thanks for the sharing.  And if i want to use this 3d position accuracy(Mavlink ATT_POS_MOCAP via serial), how to config parameters of PX4?

ajiangdaye, 2019-01-23:

r1b4z01d, 2019-03-05:
Were you able to connect your sensor to PX4?

ajiangdaye, 2019-04-15:
> Were you able to connect your sensor to PX4?

yes. it worked.

brandohando, 2020-02-28:
How did you connect it to the pixhawk @ajiangdaye ? Did you connect from the teensy to which port on the pixhawk? UART?

ajiangdaye, 2020-03-05:
> How did you connect it to the pixhawk @ajiangdaye ? Did you connect from the teensy to which port on the pixhawk? UART?

yes.

brandohando, 2020-03-05:
@ajiangdaye thanks! Was this from the micro usb on the teensy straight to the UART?

Thread 64 (2019-06-04):

how to embedded imu with this project? any small suggestion will be helpful

jayaramanrp, 2019-06-04:

ashtuchkin, 2019-06-04:
This would require significant changes to the codebase, but you can probably start with adjusting the pipeline (https://github.com/ashtuchkin/vive-diy-position-sensor/blob/master/src/vive_sensors_pipeline.cpp) to add IMU-related nodes there. You'll probably have to implement something like Kalman filter to fuse the data from IMU and this position sensor.

Sorry I'm pretty busy at the moment and can't assist you deeper.

Closed 2019-06-04.

Thread 65 (2019-09-01):

How to use Photon firmware ?

orgicus, 2019-09-01:
Hi @ashtuchkin ,

I've just got started with this project and it's amazing !
So much to learn from this!

On that note, I'm a bit stuck configuring settings for Photon. 😅
I've tried simply pasting the example config and sending that to the serial port (8N1, 57600 bps):

```properties
reset  # Reset all settings to clean state
sensor0 pin 12 positive
base0 origin -1.528180 2.433750 -1.969390 matrix -0.841840 0.332160 -0.425400 -0.046900 0.740190 0.670760 0.537680 0.584630 -0.607540
base1 origin 1.718700 2.543170 0.725060 matrix 0.458350 -0.649590 0.606590 0.028970 0.693060 0.720300 -0.888300 -0.312580 0.336480
object0 sensor0
stream0 position object0 > usb_serial
stream1 angles > usb_serial
serial1 57600
stream2 mavlink object0 ned 110 > serial1
```

and this is the output I get:
```properties
Reset successful.
config> Validation error: Unknown/unimplemented input type: 0
config> Updated: base0 origin -1.528180 2.433750 -1.969390 matrix -0.841840 0.332160 -0.425400 -0.046900 0.740190 0.670760 0.537680 0.584630 -0.607540
config> Updated: base1 origin 1.718700 2.543170 0.725060 matrix 0.458350 -0.649590 0.606590 0.028970 0.693060 0.720300 -0.888300 -0.312580 0.336480
config> Updated: object0 sensor0 0.0000 0.0000 0.0000
config> Updated: stream0 position object0 > usb_serial
config> Updated: stream1 angles > usb_serial
config> Updated: serial1 57600
config>
```

I had a look at the [photon pinout diagram](https://docs.particle.io/datasheets/wi-fi/photon-datasheet/#pinout-diagrams) and the Teensy one too. As far as I can tell from your images output is connected to pin 12 which is a digital pin.

I've tried to using pin numbers (`44,40,43,41,42,3,5,4` -> `D7,D6,D5,D4,D3,D2,D1,D0`), but I've got the same error: `Validation error: Unknown/unimplemented input type: 0`

How can I configure photon's digital pin to receive output from the rest of the circuit ?

Thank you so much,
George

P.S. If it helps I can document the provided solution into `platform-particle/notes.md` or similar

ashtuchkin, 2019-09-01:
Hey George, Photon only supports "timer" input types, so try the following (note "tim" at the end):
```
sensor0 pin <pin number> positive tim
```
Where pin number is the pin you intend to use: D0-D7 -> pin 0-7; A0-A7 -> 10-17; RX/TX -> 18/19
Recommended pins: D1, D3, RX, TX
See https://github.com/ashtuchkin/vive-diy-position-sensor/blob/master/platform-particle/input_tim.cpp#L17

orgicus, 2019-09-01:
Hi @ashtuchkin

Thank you very much for taking me one step closer!
Adding "tim" worked!

Regarding pins, I am bit confused because I'm still using the [photon pinout diagram](https://docs.particle.io/datasheets/wi-fi/photon-datasheet/#pinout-diagrams):

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

I did try all of the pins listed above (and in input_tim.cpp):

```properties
config> Updated: sensor0 pin 0 positive tim
config> Updated: sensor0 pin 1 positive tim
config> Updated: sensor0 pin 2 positive tim
config> Updated: sensor0 pin 3 positive tim
config> Validation error: Pin 4 is not connected to any timer
config> Validation error: Pin 5 is not connected to any timer
config> Validation error: Pin 6 is not connected to any timer
config> Validation error: Pin 7 is not connected to any timer
config> Validation error: Pin 10 is not connected to any timer
config> Validation error: Pin 11 is not connected to any timer
config> Validation error: Pin 12 is not connected to any timer
config> Validation error: Pin 13 is not connected to any timer
config> Updated: sensor0 pin 14 positive tim
config> Updated: sensor0 pin 15 positive tim
config> Validation error: Pin 16 is not connected to any timer
config> Updated: sensor0 pin 17 positive tim
config> Updated: sensor0 pin 18 positive tim
config> Updated: sensor0 pin 19 positive tim
```

I have reverted back to pin 3 which as far as I can tell is labeled D1 on the Photon PCB.
Also I have placed the base stations in a super simple setup:

1. base station #1 at 1.16m to the left of the photodiodes, pointing left to right
2. base station #2 at 0.25m to the right of the photodiodes, pointing right to left
3. both stations point directly at the photodiodes with no rotation at all.

The [position calculation in detail wiki](https://github.com/ashtuchkin/vive-diy-position-sensor/wiki/Position-calculation-in-detail) is super handy btw!

My assumption is the position is meters and the orientation matrix is 3x3 column major for each axis, so for no rotation at they would be identity matrices:

```log
# x           y           z
1.0000  0.0000  0.0000
0.0000  1.0000  0.0000
0.0000  0.0000  1.0000
0.0000  0.0000  0.0000

# flattened

1.0000  0.0000  0.0000 0.0000  1.0000  0.0000 0.0000  0.0000  1.0000 0.0000  0.0000  0.0000
```

I've tried this setup:

```properties
config> # Current configuration. Copy/paste to save/restore.
reset
sensor0 pin 3 positive tim
base0 origin 0.000000 0.000000 -1.160000 matrix 1.000000 0.000000 0.000000 0.000000 1.000000 0.000000 0.000000 0.000000 1.000000
base1 origin 0.000000 0.000000 -0.065000 matrix 1.000000 0.000000 0.000000 0.000000 1.000000 0.000000 0.000000 0.000000 1.000000
object0 sensor0 0.0000 0.0000 0.0000
serial1 57600
stream0 position object0 > usb_serial
stream1 angles > usb_serial
config> Validation successful.
config> Write to EEPROM successful. Type 'continue' to start using it.
config> ANG0.128994.0....
OBJ0.128994.0
ANG0.129000.0....
OBJ0.129000.0
ANG0.130000.0....
OBJ0.130000.0
ANG0.131000.0....
OBJ0.131000.0
ANG0.132000.0....
OBJ0.132000.0
ANG0.133000.0....
OBJ0.133000.0
ANG0.134000.0....
OBJ0.134000.0
ANG0.135000.0....
OBJ0.135000.0
ANG0.136000.0....
OBJ0.136000.0
ANG0.137000.0....
OBJ0.137000.0
ANG0.138000.0....
OBJ0.138000.0
ANG0.139000.0....
OBJ0.139000.0
ANG0.140000.0....
OBJ0.140000.0
ANG0.141000.0....
OBJ0.141000.0
ANG0.142000.0....
OBJ0.142000.0
```

So the firmware seems to get stuck in the `kKnoFix` state.

I've tried rotating `base1` by 180 degrees like so:
```
config> Updated: base1 origin 0.000000 0.000000 -0.065000 matrix -1.000000 0.000000 0.000000 0.000000 1.000000 0.000000 0.000000 0.000000 -1.000000
```

but the state stays the same (slow blue blink, can't get a fix).

Can you please point me in the right direction for double checking these:

1. How can I double check if I've got the right pin ? (I'm using pin D7 on Photon, assuming it's pin 3 in ST reference).
2. Do I need any other setup for the base stations ? (I only have base stations and powered them on, I don't currently have access to a full Vive VR setup).
3. Are there any other gotchas I should look out with this setup ?

I totally appreciate taking your time to support the project.

Many thanks,
George

ashtuchkin, 2019-09-01:
That's a great progress, congrats :)
Answering your questions:
1. For D7 you should use pin 7 in config. See the mapping in my previous reply (i.e. D0-7 -> pin 0-7). Also make sure the polarity is correct.
2. I think using just base stations should work fine. I haven't tried it myself though. Using identity matrices should be fine too at this stage - later on you'll be able to adjust it as needed.

At this stage I think using debugging mode could be helpful. When you see the results (`ANG0.128994.0....`), press Enter to switch to debug mode. You can then e.g. enter "sensor0 pulses" to output current decoded pulses once. Then "c" to make it print once a second, or e.g. "c 500" to print every 500 ms. Then you can use "o" command to return back to output mode.
Interesting commands in debug mode:
```
sensor0 pulses
phase show
phase off
pp angles
pp bits
pp show
pp off
```

ashtuchkin, 2019-09-01:
Also, I do recommend using pins D1 or D3 (1 or 3 in config) - they have better timers connected.

orgicus, 2019-09-01:
Hi @ashtuchkin ,

Super helpful debugging tips !
This may be a silly question but how do I double check the polarity ? 😊
I have followed your advice and switched to D1 (1 in config).

I did try the commands however I didn't get the expected output:
```
#command1: sensor0 pulses
#command2: phase show
#command3: phase off
#command4: pp angles
#command5: pp bits
#command6: pp show
#command7: pp off

#command1 result: Unknown command.
#command2 result: debug> CyclePhaseClassifier: fix 0, phase 0, pulse_base_len 62.500000, history 0x0, avg error 0.0 us
#command2 result: debug>
#command3 result: debug> Unknown command.
#command5 result: debug> Unknown command.
#command6 result: debug> PulseProcessor: fix 0, cycle id 0, num pulses 0 0 0 0, time from last pulse 0
#command7 result: debug> debug>
```

I've noticed`PointGeometryBuilder` has `debug_cmd` and `debug_print` methods, but I haven't yet figured out how to use them. I would like debug `fix_level` to try and track down why it never seems to get to `kStaleFix` for me.

Thanks again for your continued support: much appreciated !

ashtuchkin, 2019-09-03:
Polarity would be positive if you use my schematics, or negative if you use e.g. TS3633-CM1 Prototyping Module. Basically it's the direction of the pulses.

I'd start debugging step by step. First, make sure you have the pulses on the input pin, ideally using oscilloscope, ensure that the pulses are at least 4.5 volts. If you don't have oscilloscope, use debug mode (see below), it should show you the pulse lengths if it detects them. Until pulses are detected, all the other pipeline stages are irrelevant, as they don't get the input data.

For debug mode, I looked a bit more into the code and it works like this (sorry I wasn't accurate before):
```
# Start accumulating pulses in an internal array
sensor0 pulses show
# should output "accumulating.."
# Then, you can print accumulated values by pressing "Enter".
# You should see something like "Pulse0: <value> | <value> | ...  (<num> total)"
# You can press enter several times to get most recent values.
# Or you can enter "c" to output the accumulated data every second, until you press Enter again.
# To stop accumulating pulses and showing them after each "Enter", use
sensor0 pulses stop

# If you're only interested in counts, not the values themselves, use
sensor0 pulses count
# it can also be stopped by using
sensor0 pulses stop
```

You need to ensure you have a steady stream of pulses before checking other stages in the pipeline. Let me know how it goes.

orgicus, 2019-09-05:
Thank you very much for the detailed information.

I will follow up in a week or so after I do my homework and test the circuit with the oscilloscope first :)

orgicus, 2019-09-19:
@ashtuchkin I borrowed a scope and tried to have a look at what's coming in.
I'm not an electrical engineer this is the first time I use a scope, so I hope captured something useful:

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

It does look like data to me. I see a clear difference when I turn the base stations off.

I need to mention that I only have the base stations, I don't have any of the other parts (like the HMD). Having a look at issue #4 I didn't quite understand if I'll need it or not.

I've got a Teensy 3.2 in the meantime and flashed it with the firmware and I've got a very similar issue: can't get a fix.

This is the configuration I've used on Teensy:
```
reset
sensor0 pin 16 positive tim
base0 origin 0.000000 0.000000 -1.160000 matrix 1.000000 0.000000 0.000000 0.000000 1.000000 0.000000 0.000000 0.000000 1.000000
base1 origin 0.000000 0.000000 -0.065000 matrix 1.000000 0.000000 0.000000 0.000000 1.000000 0.000000 0.000000 0.000000 1.000000
object0 sensor0 0.0000 0.0000 0.0000
serial1 57600
stream0 position object0 > usb_serial
stream1 angles > usb_serial
stream2 mavlink object0 ned 110.0 > serial1
```

The physical location are mostly the same (a few centimeters off where the sensor sits in between 2 base stations on the desk).

Still `pp show` prints `PulseProcessor: fix 0, cycle id 0, num pulses 0 0 0 0, time from last pulse 0`.

Can you please help me double check the following:

1. do I need an HMD or any other accessory ? (base stations 3x3 IR grid is on, status LED is green and I see a 7-segment display showing the number 6).
2. how does pin assignment work ? do they match with Teensy pin numbering ? (e.g. for Teensy with the circuit output connected to what the Teensy datasheet shows as pin 12 results in `Validation error: Pin 12 is not supported for 'timer' input type.`, I've also tried pins 3, 6, 9, 16 with no joy and confusion over which pin number in firmware means which pin the physical board)
3. does the firmware need to get a fix one or both stations ? if the translation data in the base is a bit wrong (e.g. z translation a bit off), will the firmware still pick up the base stations, but just output offset positions ?)

Many thanks,
George

ashtuchkin, 2019-09-25:
Okay the scope shows something resembling pulses, but I can't say for sure because I need a larger picture (the screenshot you posted is 5ms wide, but the full cycle is 8.333ms). See https://github.com/ashtuchkin/vive-diy-position-sensor#how-it-works--details for what you should expect to see in a working system.

As for configuration, I'd start with just a single stream, `stream0 angles > usb_serial`. When you see the angle outputs, you'll be able to add `position` output. Mavlink is usually not needed.

For positioning, I'd move the base stations a bit away, maybe at least 1-2 meters from the sensor, ideally looking in perpendicular directions. They are not designed to be used in small spaces. Also make sure they can "see" each other - that way they'll synchronize. Alternatively, I think you can use a sync cable between them if you have it. My base stations show "b" and "c" in my setup. Make sure you follow these instructions for setting them up https://www.vive.com/us/support/vive/category_howto/installing-the-base-stations.html

Now to your questions:
> do I need an HMD or any other accessory ? (base stations 3x3 IR grid is on, status LED is green and I see a 7-segment display showing the number 6).
I honestly don't know. I haven't checked it completely without the HMD. It does work when the HMD is powered off and disconnected, but I'm not sure whether it's needed for the setup phase.

> how does pin assignment work ? do they match with Teensy pin numbering ? (e.g. for Teensy with the circuit output connected to what the Teensy datasheet shows as pin 12 results in Validation error: Pin 12 is not supported for 'timer' input type., I've also tried pins 3, 6, 9, 16 with no joy and confusion over which pin number in firmware means which pin the physical board)
They are exactly the teensy board pin numbers. The thing is, not all pins are supported in the hardware.
I used comparator input type (configured as e.g. `sensor0 pin 3 positive cmp`) for my experiments because it allows you to tune the threshold level for the pulses.
Teensy 3.2 has 3 comparators available which can be connected to pins 3, 4, 9, 11, 12 and some others (see [here](https://github.com/ashtuchkin/vive-diy-position-sensor/blob/master/platform-teensy/input_cmp.cpp#L43) for the full list).
Threshold level is a number between 0 and 64, that correspond linearly to the range from 0V to 3.3V. It can be set in configuration like this: `sensor0 pin 3 positive cmp 32` - in this case 32 is the threshold. In your case I see there's some noise below the 2V level, so I'd recommend setting threshold 2V/3.3V*64 = 38.

You can also use Timer (`tim`) input type for some other pins (see supported pins [here](https://github.com/ashtuchkin/vive-diy-position-sensor/blob/master/platform-teensy/input_ftm.cpp#L9)).

> does the firmware need to get a fix one or both stations ? if the translation data in the base is a bit wrong (e.g. z translation a bit off), will the firmware still pick up the base stations, but just output offset positions ?)
Firmware needs to get pulses from both stations to get a fix. Otherwise it can only know 2 angles from one station (`stream1 angles > usb_serial` will print give them).

orgicus, 2019-09-25:
I was hoping I can replicate a setup exactly based on what works,
but this allows me to learn a lot more about the whole process.

I'll go away and do my homework based on your info above.

Thank you so much for the detailed response.

orgicus, 2019-10-15:
@ashtuchkin Woo hoo! Finally got some plausible data ! 🎉

Using a full vive setup it was much easier to use your excellent vive-diy-position-sensor-geometry-getter utility.

I've used this setup:

```
reset
sensor0 pin 12 positive cmp 32
base0 origin 0.000000 0.344039 0.000000 matrix 0.999256 0.038564 -0.000000 -0.037983 0.984184 0.173031 0.006673 -0.172902 0.984916
base1 origin 0.394682 0.289385 -5.338341 matrix -0.999873 -0.007382 0.014130 -0.007419 0.999969 -0.002584 -0.014110 -0.002688 -0.999897
object0 sensor0 0.0000 0.0000 0.0000
serial1 57600
stream0 position object0 > usb_serial
stream1 position object0 > usb_serial
stream2 mavlink object0 ned 110.0 > serial1
```

and I now get data like this:

```
OBJ0.2205252.1000.0.4784.-0.5143.-4.3821.0.4411
OBJ0.2205285.1000.0.4770.-0.5123.-4.3848.0.4424
OBJ0.2205285.1000.0.4770.-0.5123.-4.3848.0.4424
OBJ0.2205319.1000.0.4782.-0.5125.-4.3841.0.4403
OBJ0.2205319.1000.0.4782.-0.5125.-4.3841.0.4403
OBJ0.2205352.1000.0.4787.-0.5142.-4.3816.0.4406
OBJ0.2205352.1000.0.4787.-0.5142.-4.3816.0.4406
OBJ0.2205385.1000.0.4770.-0.5122.-4.3847.0.4424
OBJ0.2205385.1000.0.4770.-0.5122.-4.3847.0.4424
OBJ0.2205419.1000.0.4782.-0.5124.-4.3839.0.4404
OBJ0.2205419.1000.0.4782.-0.5124.-4.3839.0.4404
OBJ0.2205452.1000.0.4780.-0.5137.-4.3825.0.4414
OBJ0.2205452.1000.0.4780.-0.5137.-4.3825.0.4414
OBJ0.2205485.1000.0.4770.-0.5123.-4.3846.0.4423
OBJ0.2205485.1000.0.4770.-0.5123.-4.3846.0.4423
OBJ0.2205519.1000.0.4783.-0.5129.-4.3836.0.4406
OBJ0.2205519.1000.0.4783.-0.5129.-4.3836.0.4406
OBJ0.2205552.1000.0.4780.-0.5137.-4.3825.0.4414
OBJ0.2205552.1000.0.4780.-0.5137.-4.3825.0.4414
OBJ0.3043951.1000.0.4534.-0.5150.-4.3784.0.4539
OBJ0.3043951.1000.0.4534.-0.5150.-4.3784.0.4539
OBJ0.3043984.1000.0.4533.-0.5136.-4.3801.0.4536
OBJ0.3043984.1000.0.4533.-0.5136.-4.3801.0.4536
OBJ0.3044017.1000.0.4543.-0.5156.-4.3773.0.4526
OBJ0.3044017.1000.0.4543.-0.5156.-4.3773.0.4526
OBJ0.3044051.1000.0.4534.-0.5149.-4.3784.0.4541
OBJ0.3044051.1000.0.4534.-0.5149.-4.3784.0.4541
OBJ0.3044084.1000.0.4539.-0.5143.-4.3793.0.4526
OBJ0.3044084.1000.0.4539.-0.5143.-4.3793.0.4526
OBJ0.3047417.1000.0.4533.-0.5137.-4.3802.0.4535
OBJ0.3047417.1000.0.4533.-0.5137.-4.3802.0.4535
OBJ0.3047451.1000.0.4541.-0.5139.-4.3797.0.4518
OBJ0.3047451.1000.0.4541.-0.5139.-4.3797.0.4518
OBJ0.3047484.1000.0.4541.-0.5151.-4.3783.0.4531
OBJ0.3047484.1000.0.4541.-0.5151.-4.3783.0.4531
OBJ0.3047517.1000.0.4529.-0.5132.-4.3808.0.4538
OBJ0.3047517.1000.0.4529.-0.5132.-4.3808.0.4538
OBJ0.3047551.1000.0.4546.-0.5143.-4.3792.0.4517
OBJ0.3047551.1000.0.4546.-0.5143.-4.3792.0.4517
OBJ0.3047584.1000.0.4543.-0.5147.-4.3787.0.4523
OBJ0.3047584.1000.0.4543.-0.5147.-4.3787.0.4523
OBJ0.3047617.1000.0.4532.-0.5142.-4.3797.0.4535
OBJ0.3047617.1000.0.4532.-0.5142.-4.3797.0.4535
OBJ0.3047651.1000.0.4542.-0.5139.-4.3800.0.4519
OBJ0.3047651.1000.0.4542.-0.5139.-4.3800.0.4519
OBJ0.3047684.1000.0.4532.-0.5153.-4.3782.0.4549
OBJ0.3047684.1000.0.4532.-0.5153.-4.3782.0.4549
OBJ0.3047717.1000.0.4530.-0.5141.-4.3800.0.4542
OBJ0.3047717.1000.0.4530.-0.5141.-4.3800.0.4542
OBJ0.3047751.1000.0.4546.-0.5143.-4.3792.0.4517
OBJ0.3047751.1000.0.4546.-0.5143.-4.3792.0.4517
OBJ0.3047784.1000.0.4535.-0.5154.-4.3780.0.4543
OBJ0.3047784.1000.0.4535.-0.5154.-4.3780.0.4543
OBJ0.3047817.1000.0.4529.-0.5137.-4.3804.0.4539
OBJ0.3047817.1000.0.4529.-0.5137.-4.3804.0.4539
OBJ0.3047851.1000.0.4543.-0.5152.-4.3781.0.4525
OBJ0.3047851.1000.0.4543.-0.5152.-4.3781.0.4525
OBJ0.3047884.1000.0.4537.-0.5146.-4.3789.0.4533
OBJ0.3047884.1000.0.4537.-0.5146.-4.3789.0.4533
OBJ0.3047917.1000.0.4532.-0.5133.-4.3807.0.4533
OBJ0.3047917.1000.0.4532.-0.5133.-4.3807.0.4533
OBJ0.3047951.1000.0.4546.-0.5149.-4.3787.0.4517
OBJ0.3047951.1000.0.4546.-0.5149.-4.3787.0.4517
OBJ0.3047984.1000.0.4531.-0.5149.-4.3787.0.4546
OBJ0.3047984.1000.0.4531.-0.5149.-4.3787.0.4546
OBJ0.3048017.1000.0.4529.-0.5137.-4.3804.0.4539
OBJ0.3048017.1000.0.4529.-0.5137.-4.3804.0.4539
OBJ0.3048051.1000.0.4546.-0.5148.-4.3785.0.4518
OBJ0.3048051.1000.0.4546.-0.5148.-4.3785.0.4518
OBJ0.3048084.1000.0.4538.-0.5155.-4.3778.0.4537
OBJ0.3048084.1000.0.4538.-0.5155.-4.3778.0.4537
OBJ0.3048117.1000.0.4533.-0.5142.-4.3795.0.4535
OBJ0.3048117.1000.0.4533.-0.5142.-4.3795.0.4535
OBJ0.3048151.1000.0.4544.-0.5157.-4.3777.0.4526
OBJ0.3048151.1000.0.4544.-0.5157.-4.3777.0.4526
OBJ0.3048184.1000.0.4538.-0.5155.-4.3778.0.4537
OBJ0.3048184.1000.0.4538.-0.5155.-4.3778.0.4537
OBJ0.3048217.1000.0.4533.-0.5141.-4.3796.0.4537
OBJ0.3048217.1000.0.4533.-0.5141.-4.3796.0.4537
OBJ0.3048251.1000.0.4543.-0.5152.-4.3783.0.4524
OBJ0.3048251.1000.0.4543.-0.5152.-4.3783.0.4524
OBJ0.3048284.1000.0.4534.-0.5150.-4.3784.0.4539
OBJ0.3048284.1000.0.4534.-0.5150.-4.3784.0.4539
OBJ0.3048317.1000.0.4532.-0.5133.-4.3807.0.4533
OBJ0.3048317.1000.0.4532.-0.5133.-4.3807.0.4533
OBJ0.3048351.1000.0.4547.-0.5156.-4.3775.0.4523
OBJ0.3048351.1000.0.4547.-0.5156.-4.3775.0.4523
OBJ0.3048384.1000.0.4531.-0.5150.-4.3788.0.4545
OBJ0.3048384.1000.0.4531.-0.5150.-4.3788.0.4545
OBJ0.3048417.1000.0.4533.-0.5141.-4.3796.0.4537
OBJ0.3048417.1000.0.4533.-0.5141.-4.3796.0.4537
OBJ0.3048451.1000.0.4543.-0.5152.-4.3783.0.4524
OBJ0.3048451.1000.0.4543.-0.5152.-4.3783.0.4524
OBJ0.3048484.1000.0.4533.-0.5146.-4.3790.0.4537
OBJ0.3048484.1000.0.4533.-0.5146.-4.3790.0.4537
OBJ0.3048517.1000.0.4532.-0.5138.-4.3803.0.4534
OBJ0.3048517.1000.0.4532.-0.5138.-4.3803.0.4534
OBJ0.3048551.1000.0.4544.-0.5156.-4.3774.0.4528
OBJ0.3048551.1000.0.4544.-0.5156.-4.3774.0.4528
OBJ0.3048584.1000.0.4535.-0.5154.-4.3778.0.4543
OBJ0.3048584.1000.0.4535.-0.5154.-4.3778.0.4543
OBJ0.3048617.1000.0.4532.-0.5137.-4.3801.0.4533
OBJ0.3048617.1000.0.4532.-0.5137.-4.3801.0.4533
OBJ0.3048651.1000.0.4546.-0.5152.-4.3780.0.4520
OBJ0.3048651.1000.0.4546.-0.5152.-4.3780.0.4520
OBJ0.3048684.1000.0.4531.-0.5149.-4.3787.0.4546
OBJ0.3048684.1000.0.4531.-0.5149.-4.3787.0.4546
OBJ0.3048717.1000.0.4534.-0.5141.-4.3797.0.4538
OBJ0.3048717.1000.0.4534.-0.5141.-4.3797.0.4538
OBJ0.3048751.1000.0.4547.-0.5156.-4.3773.0.4522
OBJ0.3048751.1000.0.4547.-0.5156.-4.3773.0.4522
OBJ0.3048784.1000.0.4534.-0.5146.-4.3791.0.4539
OBJ0.3048784.1000.0.4534.-0.5146.-4.3791.0.4539
OBJ0.3048817.1000.0.4536.-0.5142.-4.3795.0.4531
OBJ0.3048817.1000.0.4536.-0.5142.-4.3795.0.4531
OBJ0.3048851.1000.0.4544.-0.5156.-4.3776.0.4527
OBJ0.3048851.1000.0.4544.-0.5156.-4.3776.0.4527
OBJ0.3048884.1000.0.4534.-0.5140.-4.3796.0.4538
OBJ0.3048884.1000.0.4534.-0.5140.-4.3796.0.4538
OBJ0.3048917.1000.0.4539.-0.5137.-4.3798.0.4526
OBJ0.3048917.1000.0.4539.-0.5137.-4.3798.0.4526
OBJ0.3048951.1000.0.4547.-0.5156.-4.3773.0.4522
OBJ0.3048951.1000.0.4547.-0.5156.-4.3773.0.4522
OBJ0.3048984.1000.0.4530.-0.5140.-4.3796.0.4542
OBJ0.3048984.1000.0.4530.-0.5140.-4.3796.0.4542
OBJ0.3049017.1000.0.4538.-0.5139.-4.3798.0.4523
OBJ0.3049017.1000.0.4538.-0.5139.-4.3798.0.4523
OBJ0.3049051.1000.0.4544.-0.5156.-4.3776.0.4527
OBJ0.3049051.1000.0.4544.-0.5156.-4.3776.0.4527
OBJ0.3049084.1000.0.4533.-0.5141.-4.3796.0.4537
OBJ0.3049084.1000.0.4533.-0.5141.-4.3796.0.4537
OBJ0.3049117.1000.0.4542.-0.5139.-4.3798.0.4519
OBJ0.3049117.1000.0.4542.-0.5139.-4.3798.0.4519
OBJ0.3049151.1000.0.4547.-0.5157.-4.3774.0.4522
OBJ0.3049151.1000.0.4547.-0.5157.-4.3774.0.4522
OBJ0.3049184.1000.0.4534.-0.5141.-4.3797.0.4538
OBJ0.3049184.1000.0.4534.-0.5141.-4.3797.0.4538
OBJ0.3049217.1000.0.4539.-0.5143.-4.3793.0.4526
OBJ0.3049217.1000.0.4539.-0.5143.-4.3793.0.4526
OBJ0.3049251.1000.0.4544.-0.5152.-4.3782.0.4526
OBJ0.3049251.1000.0.4544.-0.5152.-4.3782.0.4526
OBJ0.3049284.1000.0.4535.-0.5133.-4.3806.0.4527
OBJ0.3049284.1000.0.4535.-0.5133.-4.3806.0.4527
OBJ0.3049317.1000.0.4542.-0.5139.-4.3798.0.4520
OBJ0.3049317.1000.0.4542.-0.5139.-4.3798.0.4520
OBJ0.3049351.1000.0.4544.-0.5156.-4.3777.0.4528
OBJ0.3049351.1000.0.4544.-0.5156.-4.3777.0.4528
OBJ0.3049384.1000.0.4533.-0.5137.-4.3802.0.4536
OBJ0.3049384.1000.0.4533.-0.5137.-4.3802.0.4536
OBJ0.3049417.1000.0.4542.-0.5139.-4.3798.0.4519
OBJ0.3049417.1000.0.4542.-0.5139.-4.3798.0.4519
OBJ0.3049451.1000.0.4547.-0.5156.-4.3773.0.4522
OBJ0.3049451.1000.0.4547.-0.5156.-4.3773.0.4522
OBJ0.3049484.1000.0.4533.-0.5141.-4.3794.0.4536
OBJ0.3049484.1000.0.4533.-0.5141.-4.3794.0.4536
OBJ0.3049517.1000.0.4545.-0.5139.-4.3796.0.4514
OBJ0.3049517.1000.0.4545.-0.5139.-4.3796.0.4514
OBJ0.3049551.1000.0.4544.-0.5156.-4.3776.0.4527
OBJ0.3049551.1000.0.4544.-0.5156.-4.3776.0.4527
OBJ0.3049584.1000.0.4533.-0.5137.-4.3802.0.4536
OBJ0.3049584.1000.0.4533.-0.5137.-4.3802.0.4536
OBJ0.3049617.1000.0.4541.-0.5139.-4.3799.0.4518
OBJ0.3049617.1000.0.4541.-0.5139.-4.3799.0.4518
OBJ0.3049651.1000.0.4544.-0.5156.-4.3774.0.4528
OBJ0.3049651.1000.0.4544.-0.5156.-4.3774.0.4528
OBJ0.3049684.1000.0.4534.-0.5140.-4.3796.0.4538
OBJ0.3049684.1000.0.4534.-0.5140.-4.3796.0.4538
OBJ0.3049717.1000.0.4542.-0.5139.-4.3798.0.4519
OBJ0.3049717.1000.0.4542.-0.5139.-4.3798.0.4519
OBJ0.3049751.1000.0.4543.-0.5152.-4.3781.0.4525
OBJ0.3049751.1000.0.4543.-0.5152.-4.3781.0.4525
OBJ0.3049784.1000.0.4533.-0.5137.-4.3802.0.4536
OBJ0.3049784.1000.0.4533.-0.5137.-4.3802.0.4536
OBJ0.3049817.1000.0.4542.-0.5139.-4.3798.0.4519
OBJ0.3049817.1000.0.4542.-0.5139.-4.3798.0.4519
OBJ0.3049851.1000.0.4540.-0.5151.-4.3782.0.4529
OBJ0.3049851.1000.0.4540.-0.5151.-4.3782.0.4529
OBJ0.3049884.1000.0.4533.-0.5141.-4.3795.0.4537
OBJ0.3049884.1000.0.4533.-0.5141.-4.3795.0.4537
OBJ0.3049917.1000.0.4542.-0.5139.-4.3798.0.4520
OBJ0.3049917.1000.0.4542.-0.5139.-4.3798.0.4520
OBJ0.3049951.1000.0.4544.-0.5152.-4.3782.0.4526
OBJ0.3049951.1000.0.4544.-0.5152.-4.3782.0.4526
OBJ0.3049984.1000.0.4532.-0.5138.-4.3802.0.4533
OBJ0.3049984.1000.0.4532.-0.5138.-4.3802.0.4533
OBJ0.3050017.1000.0.4543.-0.5143.-4.3793.0.4522
OBJ0.3050017.1000.0.4543.-0.5143.-4.3793.0.4522
OBJ0.3050051.1000.0.4535.-0.5150.-4.3786.0.4542
OBJ0.3050051.1000.0.4535.-0.5150.-4.3786.0.4542
OBJ0.3050084.1000.0.4534.-0.5141.-4.3797.0.4538
OBJ0.3050084.1000.0.4534.-0.5141.-4.3797.0.4538
OBJ0.3050117.1000.0.4543.-0.5147.-4.3788.0.4524
OBJ0.3050117.1000.0.4543.-0.5147.-4.3788.0.4524
```
and scope output looks like a steady signal:

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

If I understand correctly, the last 3 parts (e.g.`-0.5147 -4.3788 0.4524`) are the XYZ position, in meters. As far as I can understand angles can be calculated too, correct ?
If so:

1. what is the simplest method of streaming positions and orientations for 1 object ?
2. how is orientation/angles expressed (e.g. rx, ry in radians ?, etc.)
3. what is the position relative to (e.g. `base0`, `base1`)

Many thanks again for all your support: amazing stuff!
🙏 🙏 🙏

ashtuchkin, 2019-10-16:
Nice progress, congrats!

This is the meaning of the data values you're getting (looks like the tab characters were lost, I replaced them with spaces):
```
Example line: OBJ0 3050051 1000 0.4535 -0.5150 -4.3786 0.4542

OBJ0 - position of object #0
3050051 - timestamp in ms
1000 - fix level (see values here: https://github.com/ashtuchkin/vive-diy-position-sensor/blob/master/include/messages.h#L23)
0.4535 - X coord
-0.5150 - Y coord
-4.3786 - Z coord
0.4542 - distance between the rays from the base stations
```
The (X, Y, Z) coordinates is the position of the sensor, in the same units as were used in base station configuration (if you've used vive-diy-position-sensor-geometry-getter utility, then it's meters).

Last value, the distance between the rays, can be used as an indirect estimate of the accuracy of this setup. It uses the same units as the position coordinates. As you probably know, the sensor position is calculated by "intersecting" the virtual rays from two base stations. In reality it's very rare that they actually intersect, so instead we calculate the location where the distance between the rays is minimal. This distance is the last value here. 0.45 is pretty inaccurate, it means the distance between rays is 45cm and the position can be off up to 45 cm from the real one. You need to try to get it closer to 0.005. Maybe retry the geometry-getter utility or reposition the base stations?

Now to your questions:
> what is the simplest method of streaming positions and orientations for 1 object ?
Orientation can't be calculated by using just one sensor, you have to have several of them (afaik HTC Vive uses ~a dozen on each of their controllers). Also, I haven't got to implementing orientation calculation in this project, so you'll have to add it yourself.
> how is orientation/angles expressed (e.g. rx, ry in radians ?, etc.)
Internally we have the angles of the rays from base stations (2 for each stations, rx and ry), they are expressed in radians. You can see them if you use
```
stream1 angles object0 > usb_serial
```
> what is the position relative to (e.g. base0, base1)
It's in the same coordinate system that the base station geometry is provided. So the origin corresponds to whatever HTC Vive derives from calibration
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

Thread 66 (2019-09-11):

Error: reinterpret_cast from integer to pointer

toncho11, 2019-09-11:
Compilation failed on Windows using:

arm-none-eabi-g++.exe (GNU Tools for Arm Embedded Processors 8-2019-q3-update) 8.3.1 20190703 (release) [gcc-8-branch revision 273027]

Error:

FAILED: platform-teensy/CMakeFiles/vive-diy-position-sensor.dir/input_ftm.cpp.obj
D:\Work\ARM_Embedded\bin\arm-none-eabi-g++.exe  -DARDUINO=10607 -DF_CPU=96000000 -DLAYOUT_US_ENGLISH -DNEW_H -DTEENSYDUINO=127 -DUSB_SERIAL -D__MK20DX
256__ -I../include -I../libs/cores/teensy3 -O2 -Wall -ffunction-sections -fdata-sections -Wstack-usage=256 -mcpu=cortex-m4 -mthumb -mfp16-format=ieee
-fno-rtti -fsingle-precision-constant -Woverloaded-virtual   -std=gnu++14 -MD -MT platform-teensy/CMakeFiles/vive-diy-position-sensor.dir/input_ftm.cp
p.obj -MF platform-teensy\CMakeFiles\vive-diy-position-sensor.dir\input_ftm.cpp.obj.d -o platform-teensy/CMakeFiles/vive-diy-position-sensor.dir/input
_ftm.cpp.obj -c ../platform-teensy/input_ftm.cpp
../platform-teensy/input_ftm.cpp:53:6: error: reinterpret_cast from integer to pointer
     {&FTM0_SC, IRQ_FTM0, {{/*25*/NA, /*44*/22}, {/*26*/33, /*45*/23},  {/*27*/24, /*46*/ 9}, {      NA, /*49*/10},

ashtuchkin, 2019-09-11:
This gnu toolchain version didn't exist when this project was active :) I'm open to pull requests if you'd like to fix it.

toncho11, 2019-09-11:
I do not know the code... What is the GNU gcc version that works?

ashtuchkin, 2019-09-11:
5_4-2016q3, as specified in README.md

ashtuchkin, 2019-12-09:
Looks like you resolved it, closing.

Closed 2019-12-09.

Thread 69 (2019-12-05):

How to get the output data?

toncho11, 2019-12-05:
Data is acquired with Serial Port reader either from Arduino, Putty or other, but there is missing documentation.

This link: https://github.com/ashtuchkin/vive-diy-position-sensor/blob/docs/docs/manual.md

and this example config commands sent over the serial port should be on the main page.

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

Also at the end one needs to type "write" and reset the teensy.

toncho11, 2019-12-05:
Hi,

This info is not accessible form the main page:

https://github.com/ashtuchkin/vive-diy-position-sensor/blob/docs/docs/manual.md

toncho11, 2019-12-05:
And did "write", but still no data.

ashtuchkin, 2019-12-09:
I haven't had time to update the README, but willing to accept pull requests!

Closed 2019-12-09.

Thread 71 (2020-04-22):

output data

amralabsi, 2020-04-22:
I was wonder if there is a way to print out the x, y, z coordinates only without anything else on the tycmd monitor?

ashtuchkin, 2020-04-22:
Sure just change the code.

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

amralabsi, 2020-04-22:
I am not sure what can I change in the code to get it to print that way i read almost every file in it but i am still not sure can you point me to the folder name or file name please? I want the output to be just the x y z because I am sending it to my phone over hm10.

ashtuchkin, 2020-04-22:
This is where the position is printed:
https://github.com/ashtuchkin/vive-diy-position-sensor/blob/master/src/formatters.cpp#L56

--
Alexander Shtuchkin

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

Closed 2020-09-10.

Thread 72 (2020-07-30):

Question about OpenVR

emo10001, 2020-07-30:
Hey @ashtuchkin

You'll have to excuse my ignorance on this, but would this be tracked with OpenVR/SteamVR like a Vive tracker?  I'm interested in making something that would work with this software from Brekel:

https://brekel.com/openvr-recorder/

Is it as simple as assembling the parts and embedding the software or would there be other steps needed for it to be found by this software and/or the Vive software?

Awesome stuff.  Thanks so much!

Eric

ashtuchkin, 2020-08-03:
This project is much more low-level. It does give you current 3d coordinates with some precision, but it's nowhere near the stability of the original Vive trackers. You'll also need to get these coordinates to your computer somehow (currently the coordinates are calculated on the device itself).

Closed 2020-09-10.

Thread 73 (2020-09-10):

Cannot get sync state

tech0x, 2020-09-10:
Добрый день, подскажите пожалуйста как отдебажить сенсор.
Я выставляю порог (threshold) на уровне 36, поскольку в указанной схеме ноль после усиления почему то не получается получить. И сигнал с базовых станций начинает читаться, декодер фрейма, выдает какие то циферки, которые меняются если передвигать сенсор. Но светодиод все равно мигает с интервалом в одну секунду.
По коду насколько понимаю это сигнализирует что лок станций не произошел и сама позиция не доступна.
Что можно еще ткнуть что бы понять что подправить ?

Благодарю.

ashtuchkin, 2020-09-10:
Привет! Да, медленное мигание значит нет фикса. У модуля есть дебаг-режим, см вот здесь небольшое описание: https://github.com/ashtuchkin/vive-diy-position-sensor/issues/65#issuecomment-526940376 (и ниже по треду).

tech0x, 2020-09-11:
Добрый день,
Большое спасибо, подсказки очень полезные, у меня получилось немного подебажить и продвинуться, после установки реальных параметров баз, мигать стал не раз в секунду, а аж два раза в секунду :)).
Но почему то пока что координат не получается вытащить.
ANG0    54069   200                     
OBJ0    54069   500
ANG0    54102   200                     
OBJ0    54102   500
ANG0    54135   200                     
OBJ0    54135   500
ANG0    54169   200                     
OBJ0    54169   500
ANG0    54202   200                     
OBJ0    54202   500
ANG0    54235   200                     
OBJ0    54235   500

Хотя данные вроде как уже выглядят лучше
debug>
Pulse0:
sensor 0, time 368491501us, len 80 |
sensor 0, time 368491903us, len 122 |
sensor 0, time 368499835us, len 69 |
sensor 0, time 368500241us, len 132 |
sensor 0, time 368508167us, len 122 |
sensor 0, time 368508570us, len 60 |
sensor 0, time 368516502us, len 111 |
sensor 0, time 368516907us, len 70 |
sensor 0, time 368524834us, len 59 |
sensor 0, time 368525237us, len 122 |
sensor 0, time 368533168us, len 90 |
sensor 0, time 368533574us, len 111 |
sensor 0, time 368541501us, len 100 |
sensor 0, time 368541903us, len 81 |
sensor 0, time 368549835us, len 111 |
sensor 0, time 368550241us, len 70 (176 total)
CyclePhaseClassifier: fix 16, phase 3, pulse_base_len 59.288986, history 0x99999999, avg error 0.5 us
PulseProcessor: fix 10, cycle id 4352, num pulses 1 1 0 0, time from last pulse 7950

CyclePhaseClassifier: fix 16, phase 0, pulse_base_len 57.686787, history 0xcccccccc, avg error 1.1 us
PulseProcessor: fix 10, cycle id 8930, num pulses 1 1 0 0, time from last pulse 7928

А комманды
pp bits
pp angles
почему то не отрабатывают, хотя в коде они есть.

Не подскажите в чем может быть проблема ?
Плохой входной сигнал ?
Fix 16 пологаю это уже успешный лок ?

ashtuchkin, 2020-09-12:
ANG0 54069 200  <-- kCycleSynced = 200 - значит синхронизационные импульсы мы видим, а позиционные - нет.
OBJ0 54069 500
См вот здесь значения для FixLevel: https://github.com/ashtuchkin/vive-diy-position-sensor/blob/master/include/messages.h#L26
Нужно добиться kFullFix = 1000.

Вот здесь видно что импульсы все длинные (len = 50-150 мкс):
sensor 0, time 368491501us, len 80 |
sensor 0, time 368491903us, len 122 |
sensor 0, time 368499835us, len 69 |
sensor 0, time 368500241us, len 132 |
В работающей системе должно быть два длинных - один короткий (len = 1-7 мкс), два длинных - один короткий.

Возможно threshold нужно сделать поменьше или станции поближе подвинуть. Удачи!

tech0x, 2020-09-12:
Спасибо, весьма полезные замечания, благодаря этим замечаниям, мне удалось найти положение в котором появились короткие импульсы. В начале у одной станции, а после уменьшения дистанции между станциями в два раза получилось даже получить какую то позицию. Она походу уже валидная ?

ANG0    822502  200     -0.0083 -0.3788 0.0626  -0.4191
OBJ0    822502  1000    0.7580  -1.0367 -0.6598 0.7616
ANG0    822536  200     -0.0023 -0.3764 0.0625  -0.4192
OBJ0    822536  1000    0.7549  -1.0264 -0.6760 0.7424
ANG0    822569  200     0.0053  -0.3751 0.0625  -0.4191
OBJ0    822569  1000    0.7484  -1.0190 -0.6924 0.7154
ANG0    822602  200     0.0139  -0.3725 0.0627  -0.4191
OBJ0    822602  1000    0.7430  -1.0065 -0.7135 0.6851
ANG0    822636  200     0.0227  -0.3712 0.0626  -0.4190
OBJ0    822636  1000    0.7347  -0.9981 -0.7322 0.6537
ANG0    822669  200     0.0308  -0.3717 0.0625  -0.4191
OBJ0    822669  1000    0.7250  -0.9965 -0.7466 0.6231
ANG0    822702  200     0.0383  -0.3714 0.0623  -0.4191
OBJ0    822702  1000    0.7168  -0.9916 -0.7614 0.5953
ANG0    822736  200     0.0461  -0.3672 0.0625  -0.4190
OBJ0    822736  1000    0.7136  -0.9735 -0.7833 0.5702
ANG0    822769  200     0.0539  -0.3605 0.0625  -0.4190
OBJ0    822769  1000    0.7139  -0.9469 -0.8103 0.5485
ANG0    822802  200     0.0620  -0.3516 0.0626  -0.4191
OBJ0    822802  1000    0.7172  -0.9126 -0.8422 0.5279

Вопрос кроме трешолда что еще можно сделать что бы возможно было увеличить дистанцию ?
Попробовать сменить светодиоды ?
Поковырять фильтры помех ?
Один момент который может быть важен, тестирую все это дело ночью, поскольку днем сигнал явно забивается, солнечным светом. Подозреваю что фотоэллементы с алиекспресса, работают по несколько альтернативным принципам.

tech0x, 2020-09-14:
Я нацепил гирлянду из светодиодов в (9 штук) и получилось таки расширить пятно в котором датчик получает данные с баз, но дистанция от базы варирует метр полтора, поэтому можно получить либо с одной базы либо с другой. А вот совместить их вместе пока не получилось.
Но мне кажется я нашел в чем сложность.
У меня нет чувствительного осцилографа и я подключил ардуинку к выходу с усилителя и поднял счетчик длительности импульсов. И вполне стал регистрировать короткие импульсы длительностью в 16 микросекунд с очевидными интервалами, в тоже время  sensor0 impulses show эти короткие импульсы не регистрировал.
У меня складывается впечатление что здесь лазерный луч имеет также свойства рассеиваться в зависимости от дистанции из-за чего импульсы увеличиваются по длительности из-за чего софт их фильтрует.
Стало бы вопрос, как граммотно поднять верхний лимит на продолжительность коротких импульсов ?
Премного благодарен за Ваш труд.

ashtuchkin, 2020-09-14:
Логика классификации импульсов на короткие и длинные вот здесь https://github.com/ashtuchkin/vive-diy-position-sensor/blob/master/src/pulse_processor.cpp#L44   Все импульсы до 40мкс - короткие, от 40 до 300 - длинные. Но если импульсов нет в "sensor0 impulses show", то проблема раньше, надо смотреть какие входы используются и как. У Teensy есть два варианта входов - компаратор (с threshold) или обычный таймер, можно попробовать переключить на другой вариант и попробовать.

Но в целом я думаю проблема в другом. Мне кажется нужно смотреть схематику фотодиода/усилителя - 16 мкс это слишком много для лазерного луча, не может он так рассеиваться. А вот фотодиод или усилитель может иметь нежелательный RC контур (сопротивление/ёмкость), такой, что сигнал "сглаживается" и вместо четкого короткого импульса получается длинный и гораздо слабее. На осциллографе это было бы хорошо видно.

Я сам когда эту схему делал много экспериментировал с сопротивлениями и конденсаторами, чтобы получить хорошую чувствительность. Думаю с китайскими компонентами это нужно заново делать.

Если не хочется этим заниматься, есть уже настроенные модули с гораздо большей чувствительностью - [TS3633-CM1](https://triadsemi.com/product/ts3633-cm1-prototyping-module/), если есть возможность их заказать то рекомендую.

tech0x, 2020-09-14:
https://github.com/nairol/LighthouseRedox/blob/master/docs/Light%20Emissions.md
Тут указан что короткий синхроимпульс j0 может быть до 62.5 микросекунды в зависимости от положения базы.
E.g. sync pulse j0 can be 2501-3000 ticks long depending on the position and orientation relative to the base station.
Это о другом речь или таки нужно увеличивать размер  для коротких пакетов ?

С сигналом я поработал, форма получилась вполне хорошая, почти идеальная на больших импульсах хорошо видно,
хотя да пришлось перебирать все кондеры и резисторы и подавать на первую ногу усилителя, а не на вторую как в Вашей схеме, поскольку там действительно получался сигнал хуже. Фотоэллементы конечно попробую заказать, просто с этими не понятно толи они их делают то ли нет. А больше  их в других местах не продается.

А насчет коротких импульсов я их заставил ходить весьма варваским ковырянием кода
constexpr TimeDelta min_long_pulse_len(70, usec);

constexpr TimeDelta short_pulse_min_time = angle_center_len - cycle_period / 3;
constexpr TimeDelta short_pulse_max_time = angle_center_len + cycle_period / 3;
Переборирая эти параматры короткие импульсы таки появились, в пульсах.

Только пока не разобрался, если синхроимпульс может быть таким большим как его сюда правильно стоило бы оформить ?
constexpr TimeDelta short_pulse_min_time = angle_center_len - cycle_period / 3;
constexpr TimeDelta short_pulse_max_time = angle_center_len + cycle_period / 3;

tech0x, 2020-09-14:
Да, так и есть с таким набором параметров, вероятно конечно он не правильный, но мне удалось впервые получить правдоподобные координаты, при условии что базовые станции находятся примерно на 4-4.5 м друг от друга , правда пока только в определенных местах, почему то лучше работает по краям базовых станций. А центра почему то не охотно.

constexpr TimeDelta min_long_pulse_len(70, usec);
constexpr TimeDelta max_long_pulse_len(280, usec);

constexpr TimeDelta long_pulse_starts_accepted_range(72, usec);
constexpr TimeDelta long_pulse_starts[num_base_stations] = {TimeDelta(0, usec), TimeDelta(410, usec)};

constexpr TimeDelta cycle_period(8333, usec);  // Total len of 1 cycle.
constexpr TimeDelta angle_center_len(4000, usec);
constexpr TimeDelta short_pulse_min_time = angle_center_len - cycle_period / 2;
constexpr TimeDelta short_pulse_max_time = angle_center_len + cycle_period / 2;

OBJ0    664579  1000    0.7672  0.0337  -1.7219 3.7041
OBJ0    664612  1000    0.7671  0.0310  -1.7241 3.7035
OBJ0    664646  800     0.7676  0.0302  -1.7248 3.7031
OBJ0    664679  800     0.7672  0.0294  -1.7258 3.7026
OBJ0    664712  800     0.7666  0.0356  -1.7212 3.7035
OBJ0    664746  800     0.7666  0.0359  -1.7205 3.7042
OBJ0    664779  1000    0.7669  0.0337  -1.7224 3.7034
OBJ0    664812  800     0.7667  0.0324  -1.7231 3.7036
OBJ0    664846  800     0.7672  0.0312  -1.7246 3.7025
OBJ0    664879  800     0.7665  0.0362  -1.7205 3.7037
OBJ0    664912  800     0.7666  0.0352  -1.7213 3.7035
OBJ0    664946  500

OBJ0    664979  500
debug> sensor0 pulses show
Pulse0: accumulating..
debug>.
Pulse0:.
sensor 0, time 671924408us, len 33 |.
sensor 0, time 671928626us, len 238 |.
sensor 0, time 671929052us, len 132 |.
sensor 0, time 671931326us, len 43 |.
sensor 0, time 671936960us, len 283 |.
sensor 0, time 671937384us, len 59 |.
sensor 0, time 671945293us, len 269 |.
sensor 0, time 671945719us, len 69 |.
sensor 0, time 671953627us, len 221 |.
sensor 0, time 671954052us, len 121 |.
sensor 0, time 671957741us, len 33 |.
sensor 0, time 671961960us, len 203 |.
sensor 0, time 671962386us, len 110 |.
sensor 0, time 671964659us, len 43 |.
sensor 0, time 671970293us, len 254 |.
sensor 0, time 671970718us, len 58 (212 total)

ashtuchkin, 2020-09-15:
> Тут указан что короткий синхроимпульс j0 может быть до 62.5 микросекунды в зависимости от положения базы. E.g. sync pulse j0 can be 2501-3000 ticks long depending on the position and orientation relative to the base station. Это о другом речь или таки нужно увеличивать размер для коротких пакетов ?

О другом - там 3 импульса должны регистрироваться каждый цикл (8333 мкс):
 1. Синхроимпульс A - излучается светодиодами базовой станции А, длина ~62.5-300 мкс, начинается в t+0
 2. Синхроимпульс B - излучается светодиодами базовой станции B, длина ~62.5-300 мкс, начинается в t+420мкс
 3. "Позиционный" импульс - излучается лазером одной из станций, длина обычно 2-3 мкс, по положению этого импульса мы определяем угол.

В коде я называю первые 2 импульса "long pulses", третий - "short". Не уверен что изменения в коде помогли - мне кажется они скорее делают так что второй импульс распознается как третий.

Импульсы которые указаны выше мы можем классифицировать вот так:
```
sensor 0, time 671924408us, len 33 |.  t0+4115: импульс 3 (предыдущего цикла)
sensor 0, time 671928626us, len 238 |.  начало цикла t0: импульс 1
sensor 0, time 671929052us, len 132 |.  t0+420: импульс 2
sensor 0, time 671931326us, len 43 |.   t0+2700: импульс 3.
sensor 0, time 671936960us, len 283 |.  начало цикла t0: импульс 1
sensor 0, time 671937384us, len 59 |.   t0+420: импульс 2
sensor 0, time 671945293us, len 269 |.  начало цикла t0: импульс 1
sensor 0, time 671945719us, len 69 |.   t0+420: импульс 2
sensor 0, time 671953627us, len 221 |.  начало цикла t0: импульс 1
sensor 0, time 671954052us, len 121 |.  t0+420: импульс 2
sensor 0, time 671957741us, len 33 |.   t0+4114: импульс 3
sensor 0, time 671961960us, len 203 |.  начало цикла t0: импульс 1
sensor 0, time 671962386us, len 110 |.  t0+420: импульс 2
sensor 0, time 671964659us, len 43 |.   t0+2699: импульс 3
sensor 0, time 671970293us, len 254 |.  начало цикла t0: импульс 1
sensor 0, time 671970718us, len 58      t0+420: импульс 2
```
Что мы видим здесь:
 Импульсы 1 и 2 имеют длину 58 - 283 мкс
 Импульс 3 регистрируется только от одной базовой станции и длина его ~33-43 мкс. Скорее всего усилители "размазывают" сигнал, либо базовая станция слишком близко находится. Большая длина здесь это плохо, т.к. это напрямую отражается на точности измерения угла => точности измерения позиции.

По поводу изменений в коде:
constexpr TimeDelta min_long_pulse_len(70, usec);      <- это threshold между синхро и позиционными импульсами. Исходя из примера выше, лучше поставить 50.
constexpr TimeDelta max_long_pulse_len(280, usec);  <- этот можно увеличить немного т.к. некоторые синхро импульсы шире. Например 300 или 350.

constexpr TimeDelta long_pulse_starts_accepted_range(72, usec);
constexpr TimeDelta long_pulse_starts[num_base_stations] = {TimeDelta(0, usec), TimeDelta(410, usec)};

constexpr TimeDelta cycle_period(8333, usec); // Total len of 1 cycle.
constexpr TimeDelta angle_center_len(4000, usec);
constexpr TimeDelta short_pulse_min_time = angle_center_len - cycle_period / 2;  <- здесь лучше вернуть /3, т.к. иначе короткие и длинные импульсы будут смешиваться.
constexpr TimeDelta short_pulse_max_time = angle_center_len + cycle_period / 2;  <- тоже лучше вернуть.

Почему /3? Внутри базовой станции лазеры вращаются синхронизировано с циклом 8333 мкс. За один цикл они делают 180 градусов поворот, причем так, чтобы в t0+4000 лазер светил прямо по центру. Т.к. светит станция на 120 градусов вперед (-60 до +60), то мы рассчитываем минимальную и максимальную позицию импульса в цикле как (4000 - 8333 * 60 / 180) и 4000 + (8333 * 60 / 180). Из этого и происходит cycle_period / 3. Побочный эффект этой проверки в том, что синхроимпульсы не конфликтуют с позиционным импульсом: short_pulse_min_time = 1222 мкс, больше чем 420 + max_long_pulse_len.

Далее, вот это кажется как будто фикс, но скорее всего нет, т.к. последнее значение слишком большое. Это расстояние между рассчитанными линиями от базовых станций, в метрах. Это значение примерно показывает точность определения координат и должно быть ~0.01.
OBJ0 664579 1000 0.7672 0.0337 -1.7219 3.7041

tech0x, 2020-09-15:
Да, похоже Вы абсолютно правы,
я таки нашел короткий импульс осцилографом похоже уровень сигнала становиться недостаточным для усиления.
Благодарю, за уделенное время.

ashtuchkin, 2020-09-16:
Рад был помочь, удачи!

Closed 2020-09-15.

Thread 74 (2020-09-29):

Increase precision

toncho11, 2020-09-29:
Hi,

How can the precision be increased? It seems like 1 cm which is not enough for us.

ashtuchkin, 2020-09-29:
It can't be increased, you'll have to use a different solution.

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

toncho11, 2020-09-30:
But you say:

"3d position accuracy: currently ~10mm; less than 2mm possible with additional work."

What is this additional work?

LeeCookGHA, 2020-09-30:
Increase the number of photo detectors, some additional sensors and then use
https://github.com/cntools/libsurvive for pose estimation.

ashtuchkin, 2020-09-30:
Yep you'll need multiple sensors, certainly not DIY (TS3633-CM1
<https://www.triadsemi.com/product/ts3633-cm1/> work much better), and then
you'll need to do additional research on how to fuse their data.

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

luoxz-ai, 2022-01-15:
Can't buy TS3633-CM1 devices anymore

Closed 2021-07-06.

Thread 75 (2020-12-15):

Guide for a complete newbie

IMKIERA, 2020-12-15:
Hello!

As I said, I'm a complete newbie to the whole programming world but I'm so desperate in working with this project. As of starting I read the Readme file and I started with understanding the software part. Viz; CMake, GNU tool, Ninja and also Eclipse. But according to me, I haven't progressed a bit, how much ever I study or see tutorials on youtube I'm unable to go through this project but somehow I managed to understand what and how each of these software works.

And I'm working with **STM32 board** and I don't even know how to get that whole programme transferred to this or write everything.

So all in all, need a complete starter guide to get started with this project for posterity.
Because, I think there might be many like me out there in hunt of this info!
I know it'll be hard to give a complete starter guide but at least some guide links would be of much help.

Thanks in advance
To all whoever trynna put effort to answer this.

greyham1, 2021-02-25:
I started to build a [EMG ](https://web.archive.org/web/20100621033130/http://www.open-ecg-project.org/tiki-read_article.php?articleId=1) awhile ago. You should learn to solder. it will help.
this project uses a teensey, and a STM32 is not that afaik. If you use any other board, you will need to learn to code
1 Buy the materials from digikey or somewhere, then use the pictures to assemble them. Buy 2 sets
2 get [arduino IDE](https://www.arduino.cc/en/main/OldSoftwareReleases)
3 use the code from this project to program it using a [FTTI](https://www.aliexpress.com/item/10000348302604.html)
4 ???
5 connect it to steam somehow

greyham1, 2021-02-25:
I started to build a [EMG ](https://web.archive.org/web/20100621033130/http://www.open-ecg-project.org/tiki-read_article.php?articleId=1) awhile ago. You should learn to solder. it will help.
this project uses a teensey, and a STM32 is not that afaik. If you use any other board, you will need to learn to code
1 Buy the materials from digikey or somewhere, then use the pictures to assemble them. Buy 2 sets
2 get [arduino IDE](https://www.arduino.cc/en/main/OldSoftwareReleases)
3 use the code from this project to program it using a [FTTI](https://www.aliexpress.com/item/10000348302604.html)
4 ???
5 connect it to steam somehow

GRJ1, 2021-02-25:
I started to build a [EMG ](https://web.archive.org/web/20100621033130/http://www.open-ecg-project.org/tiki-read_article.php?articleId=1) awhile ago. You should learn to solder. it will help.
this project uses a teensey, and a STM32 is not that afaik. If you use any other board, you will need to learn to code
1 Buy the materials from digikey or somewhere, then use the pictures to assemble them. Buy 2 sets
2 get [arduino IDE](https://www.arduino.cc/en/main/OldSoftwareReleases)
3 use the code from this project to program it using a [FTTI](https://www.aliexpress.com/item/10000348302604.html)
4 ???
5 connect it to steam somehow

IMKIERA, 2021-02-25:
Thank you so much @GRJ1

Btw, After all these days I've managed to get quite ahead with the project and now stuck with understanding coding part! Theory part I've an idea. but to write program I feel like I'm playing with merry-go-round. (haha) As I said I'm new to coding, I'm not even getting a single meaning out of program. I mean I'm not able to understand the program part even though how much ever I study with Intro to C, C#...

basically I need info, On explaining program into some understandable English. At least kinda flow chart might also be helpful. If somehow I get through I'll try to contribute here.

If anyone have any suggestions open to it.

cheers!

GRJ1, 2021-02-25:
If you follow the code while it's running issuing eclipse or your chosen ide you should be able to see the order the code is executing and which functions can which functions and do what.
once you find the initial file it should be just a matter of time as long as you have all the libraries installed
I doubt anyone's going to provide a map but there are other people who've used this code if you google

IMKIERA, 2021-02-26:
Thanks again @GRJ1
That's really helpful.

Closed 2021-07-06.

Thread 77 (2021-04-18):

Compatability with other microprocessors?

LittleNyanCat, 2021-04-18:
The teensy 3.2 can be quite expensive, especially for us overseas folks, is there something preventing the code from being ported to another microcontroller such as the ESP32?
It seems to have specs about on par if not better, and it's wireless capabilities are very enticing for potential VR projects of mine (and quite a few others)

ashtuchkin, 2021-04-19:
I'm not familiar with ESP32, so can't tell for sure, but it seems doable.
Make sure the chip has good hardware timers with at at least .5-1 ns
precision.

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

Closed 2021-07-06.

Thread 80 (2022-02-03):

"'reinterpret_cast' from integer to pointer" error during compiling

XDAChen, 2022-02-03:
Hi,
I was getting this error message during compiling:

> error: 'reinterpret_cast' from integer to pointer
   53 |     {&FTM0_SC, IRQ_FTM0, {{/*25*/NA, /*44*/22}, {/*26*/33, /*45*/23},  {/*27*/24, /*46*/ 9}, {      NA, /*49*/10},
make[2]: *** [platform-teensy/CMakeFiles/vive-diy-position-sensor.dir/input_ftm.cpp.obj] Error 1

I then went to the code and changed from:

`// FTM definitions: Ports, Interrupts and Input pins.
constexpr static FTMDef timer_defs[] = {
#if defined(__MK20DX128__) || defined(__MK20DX256__)  // Teensy 3.0, 3.1, 3.2. Chip 64 LQFP pin numbers in comments. Teensy digital pins as numbers.
    {&FTM0_SC, IRQ_FTM0, {{/*25*/NA, /*44*/22}, {/*26*/33, /*45*/23},  {/*27*/24, /*46*/ 9}, {      NA, /*49*/10},`

to the following:

`// FTM definitions: Ports, Interrupts and Input pins.
static FTMDef timer_defs[] = {
#if defined(__MK20DX128__) || defined(__MK20DX256__)  // Teensy 3.0, 3.1, 3.2. Chip 64 LQFP pin numbers in comments. Teensy digital pins as numbers.
    {&FTM0_SC, IRQ_FTM0, {{/*25*/NA, /*44*/22}, {/*26*/33, /*45*/23},  {/*27*/24, /*46*/ 9}, {      NA, /*49*/10},`

After I deleted _constexpr_ it did successfully compiled and I was able to upload the hex file to my teensy3.2 via Tycommander GUI.

The serial port currently outputs nothing, I am going to build the light sensor and set up vive lighthouse and see if I can get data.

I had checked online it seems that the later version of GCC gives this as an error rather than a warning. I am very rudimentary to cpp so I wonder if there is a better solution than a) changing the code like I did (not sure if it works) or b) installing an older version of GCC?

ashtuchkin, 2022-02-03:
Sorry it's been a while since I last compiled this project and I don't have ARM GCC installed now, so hard to advise anything. Hope what you did works.

XDAChen, 2022-02-03:
Hi Alexander, wondering if you can give some clarification on what the line is declaring:

`// FTM definitions: Ports, Interrupts and Input pins. static FTMDef timer_defs[] = { #if defined(__MK20DX128__) || defined(__MK20DX256__) // Teensy 3.0, 3.1, 3.2. Chip 64 LQFP pin numbers in comments. Teensy digital pins as numbers. {&FTM0_SC, IRQ_FTM0, {{/*25*/NA, /*44*/22}, {/*26*/33, /*45*/23}, {/*27*/24, /*46*/ 9}, { NA, /*49*/10},`

So far I am not getting any serial data in at my monitor. I wonder when I deleted constexpr it did not successor define the pins on the teensy-board.

Thanks!

ashtuchkin, 2022-02-04:
Those are hardware timer module definitions for different versions of teensy. For each timer, it contains interrupt number, pin numbers, etc.

XDAChen, 2022-02-04:
thanks Alex. I got successfully compiled and upload the original .Hex file onto the my teensy board. The board flashes its LED twice rapidly and periodically. However still not receiving any serial data on my Tycommander screen (I had tried Arduino + teensyduino, nothing shows up neither).
Any clue to this problem?

Thanks

ashtuchkin, 2022-02-06:
Are you referring to this manual? https://github.com/ashtuchkin/vive-diy-position-sensor/blob/docs/docs/manual.md  I've started to write it back in the day, but didn't have time to finish. I don't have anything else, sorry. There's some more info in the issues like #65, #73.

XDAChen, 2022-02-06:
I could pull in a more elaborate explanation for it :-)

ashtuchkin, 2022-02-17:
Sorry it's been a long time since I last touched this project, so it would take some time for me to reestablish the context, which I don't have. Let me know if you'd like to contribute a more elaborate explanation so that other people can use it.

XDAChen, 2022-02-21:
Hi Alex,

Yes I would love to provide a more complete description for others. For now
I am working on other parts of my project and will circle back to it very
soon.

Thanks

On Thu, Feb 17, 2022 at 1:22 AM Alexander Shtuchkin <
***@***.***> wrote:

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

Thread 82 (2022-02-17):

How to use tycmd in windows ?

luoxz-ai, 2022-02-17:
How to use tycmd in windows ?

How can I configure the module as you stated in https://github.com/ashtuchkin/vive-diy-position-sensor/blob/docs/docs/manual.md ?

Can the arduino serial port be able to view the debug output information?

luoxz-ai, 2022-02-17:
upload  releases tag v1.0-alpha2    vive-diy-position-sensor.hex ,   how to output the position to the screen？

ashtuchkin, 2022-02-17:
> How to use tycmd in windows ?
I don't know, I don't use windows.

> How can I configure the module as you stated in https://github.com/ashtuchkin/vive-diy-position-sensor/blob/docs/docs/manual.md ?
When you establish serial connection, press enter, it should show you the prompt ("> "). After that, enter your hardware configuration as written in the manual. See also #65, #73.

> Can the arduino serial port be able to view the debug output information?
No, only serial over usb at this point.

> upload releases tag v1.0-alpha2 vive-diy-position-sensor.hex , how to output the position to the screen？
After you connect your teensy/particle to the the sensor and enter the hardware configuration via serial-over-usb, it will wait for the "fix" and start outputting position to whatever port you set in the hardware configuration.

luoxz-ai, 2022-02-17:
[vive_sensor_breadboard.pdf](https://github.com/ashtuchkin/vive-diy-position-sensor/files/8086101/vive_sensor_breadboard.pdf)

luoxz-ai, 2022-02-17:
The arduino is also connected through the usb serial port. Can you interact with the command to get the location debugging information and output it to the screen?

luoxz-ai, 2022-02-17:
https://www.pjrc.com/teensy/tutorial3.html

luoxz-ai, 2022-02-17:
https://www.pjrc.com/teensy/usb_serial.html

[serial_install.exe](https://www.pjrc.com/teensy/serial_install.exe)

USB: Virtual Serial Port？

luoxz-ai, 2022-02-17:
https://github.com/Koromix/tytools/releases

#53

Use [tytools](https://github.com/Koromix/tytools) (if i remember correctly the command should be 'tycmd monitor') with this you acces the teensy, to exit debug mode (in case you start in it) type '!' (this should put you in config mode).
than you can use the above linked commands in said config mode.

ashtuchkin, 2022-02-17:
For schematics, please use the one in the README.md (right below the words "Full schematics:").
This project does not support Arduino. Only Teensy or Particle.

> Can you interact with the command to get the location debugging information and output it to the screen?

Yes. Specifically the following configuration line does it (note "usb_serial"):
```
stream0 position object0 > usb_serial
```

I'm not sure what you're asking in the other questions.

luoxz-ai, 2022-02-21:
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

Thread 83 (2022-10-31):

Interpolation during lighthouse outage

WillNilges, 2022-10-31:
👋🏻 Hey there! I'm interested in this project, looks super cool!

I had a question about your requirement of having two lighthouses visible: How _necessary_ is that? Is there any amount of interpolation for in case there's a brief period of invisibility? What's the behavior like if there's not a signal from two lighthouses?

ashtuchkin, 2022-11-01:
Hey Willard, happy you're finding the project useful.

Current code does not include any interpolation or IMU fusing logic - that
seems like it should be in a separate, higher level library. Depending on
the usage the requirements will be different, so I opted not to do it in
the lib.

Alex.

On Mon, Oct 31, 2022 at 3:54 PM Willard Nilges ***@***.***>
wrote:

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

Thread 88 (2024-12-25):

ESP32 integration

PaulKokhanov1, 2024-12-25:
I had a quick question about all the needed aspects of the code that would need to change in order to have the 3d positioning work with an esp32 micro-controller? I understand the platform code will need to change but is there any further insight into which parts will need to be redone? Has anyone already began working on such a re-implementation?

Thanks.

ashtuchkin, 2024-12-28:
It's been a long time since I looked into it, but yes, platform integration + you'll need to make sure that esp32 has high-quality hardware timers that can measure at least 0.5-1 microsecond resolution.

PaulKokhanov1, 2024-12-28:
Thanks for the response Alex, I just had a follow up question. I decided to try to re-implement the 3d position tracking on the esp32 via the Arduino IDE and I have been noticing some strange behavior. I'd hope you may be able to give me further insight.
Basically, here is a sample of the pulses that I am seeing,

Index 0: Width = 137 us, StartTime = 104756328 us
Index 1: Width = 5 us, StartTime = 104758195 us
Index 2: Width = 97 us, StartTime = 104763468 us
Index 3: Width = 85 us, StartTime = 104764662 us
Index 4: Width = 8 us, StartTime = 104766918 us
Index 5: Width = 9 us, StartTime = 104769471 us
Index 6: Width = 65 us, StartTime = 104771804 us
Index 7: Width = 75 us, StartTime = 104772995 us
Index 8: Width = 7 us, StartTime = 104774861 us
Index 9: Width = 9 us, StartTime = 104777348 us
Index 10: Width = 75 us, StartTime = 104780136 us
Index 11: Width = 106 us, StartTime = 104781329 us
Index 12: Width = 9 us, StartTime = 104783587 us
Index 13: Width = 65 us, StartTime = 104788471 us
Index 14: Width = 116 us, StartTime = 104789663 us
Index 15: Width = 5 us, StartTime = 104791528 us
Index 16: Width = 97 us, StartTime = 104796803 us
Index 17: Width = 85 us, StartTime = 104797996 us
Index 18: Width = 8 us, StartTime = 104800257 us
Index 19: Width = 9 us, StartTime = 104802810 us
Index 20: Width = 85 us, StartTime = 104805139 us
Index 21: Width = 96 us, StartTime = 104806330 us
Index 22: Width = 6 us, StartTime = 104808194 us
Index 23: Width = 8 us, StartTime = 104810686 us

As you can see I am nearly getting the expected Long Long Short pulse pattern, however there seems to be extra short pulses sometimes being picked up, would you happen to know why this is the case?
More importantly though is that as you can see the cycle order is not as expected, for example, if we ignore the two consecutive short pulses and just examine the long pulses we see the following pattern:
B sweep, A sweep, A sweep, A sweep, B sweep, etc...
this is obviously not the expected AABB pattern.

Within this question (https://github.com/ashtuchkin/vive-diy-position-sensor/issues/26) I saw you indicated that the individual may be missing some cycles, now I don't believe this is the case in my situation because none of the start time differences are greater than the cycle length of 8333 usec thus I am not too sure what could be the issue. If you could provide any insight or potential further considerations I'd really appreciate it! Thanks :)

I do know that the ESP32 does have hardware timers that can measure with a 1 usec resolution

ashtuchkin, 2024-12-30:
> As you can see I am nearly getting the expected Long Long Short pulse pattern, however there seems to be extra short pulses sometimes being picked up, would you happen to know why this is the case?

One guess is there might be something acting as a mirror nearby. Another guess is something with electronics - extra capacitance somewhere, etc. It took me some time with oscilloscope to figure out good thresholds/amplification factor.

> B sweep, A sweep, A sweep, A sweep, B sweep, etc...this is obviously not the expected AABB pattern.

Ok I see a good 8333us pattern, but the distance between first and second long pulses is ~1200us, which is much larger than 400us I got. Are you using original HTC Vive base stations? Maybe they changed something in their protocol in the last 7 years? Not sure.

PaulKokhanov1, 2024-12-30:
> One guess is there might be something acting as a mirror nearby. Another guess is something with electronics - extra capacitance somewhere, etc. It took me some time with oscilloscope to figure out good thresholds/amplification factor.

Ya I was suspecting that, could even the reflection off the resistor cause this? I'll have to experiment more.

> Ok I see a good 8333us pattern, but the distance between first and second long pulses is ~1200us, which is much larger than 400us I got. Are you using original HTC Vive base stations? Maybe they changed something in their protocol in the last 7 years? Not sure.

Ya I'm using the original HTC Vive base stations, its possible they could have changed something but I do feel that's unlikely as I haven't heard/seen anything mentioned within other individuals issues within this repo, but again i'll look into this. Another thing I should've mentioned is this what was I saw on an oscilloscope,

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

Note this was done with 1 Base Station in the above image. One thing I couldn't find online is the refresh rate of a single BS? Are we still going through an entire cycle in 8.333 ms? Or does it change when dealing with only 1? Furthermore, the long pulse seems to be around 320 usec in this case which seems slightly large? Could this be due to a faulty circuit? I may need to create a pcb for it. Thanks again for your help.

Closed 2024-12-28.
