ashtuchkin/vive-diy-position-sensor/src/outputs.cpp

#include "outputs.h"

OutputNode::OutputNode(uint32_t idx, const OutputDef& def)
    : node_idx_(idx)
    , def_(def)
    , chunk_{}
    , exclusive_mode_(false)
    , exclusive_stream_idx_(0) {
}

std::unique_ptr<OutputNode> OutputNode::create(uint32_t idx, const OutputDef& def) {
    for (auto creator_fn : OutputNode::CreatorRegistrar::iterate())
        if (auto node = creator_fn(idx, def))
            return node;
    throw_printf("Invalid output with index: %d", idx);
}

void OutputNode::consume(const DataChunk &chunk) {
    if (exclusive_mode_ && exclusive_stream_idx_ != chunk.stream_idx)
        return;
    
    // NOTE: This will wait until we can fit data into write buffer. Can cause a delay.
    write(&chunk.data[0], chunk.data.size());
}

void OutputNode::consume(const OutputCommand& cmd) {
    switch (cmd.type) {
        case OutputCommandType::kMakeExclusive: exclusive_mode_ = true; exclusive_stream_idx_ = cmd.stream_idx; break;
        case OutputCommandType::kMakeNonExclusive: exclusive_mode_ = false; break;
    }
}

void OutputNode::do_work(Timestamp cur_time) {
    // Accumulate bytes read from the stream_ in the chunk_.
    while (!chunk_.data.full()) {
        int c = read();
        if (c < 0)
            break;
        chunk_.time = cur_time;  // Store the time of the last byte read.
        chunk_.data.push(c);
    }

    // Send chunk if data is full or time from last byte is over given threshold.
    constexpr TimeDelta max_time_from_last_byte(1, msec);
    if (chunk_.data.full() || (!chunk_.data.empty() && cur_time - chunk_.time > max_time_from_last_byte)) {
        chunk_.last_chunk = !chunk_.data.full();
        chunk_.stream_idx = node_idx_;
        produce(chunk_);
        chunk_.data.clear();
    }
}



// ======  OutputDef I/O  =====================================================

void OutputDef::print_def(uint32_t idx, PrintStream &stream) {
    if (idx == 0 && !active) {
        stream.printf("usb_serial off\n");
    } else if (idx != 0 && active) {
        stream.printf("serial%d %d\n", idx, bitrate);
    }
}

bool OutputDef::parse_def(uint32_t idx, HashedWord *input_words, PrintStream &err_stream) {
    if (idx == 0 || idx == (uint32_t)-1) {
        // usb_serial: do nothing unless turned off.
        active = (*input_words != "off"_hash);
        return true;
    } else if (idx < num_outputs) {
        // hardware serial
        active = true;
        if (!input_words->as_uint32(&bitrate) || !(300 <= bitrate && bitrate <= 115200)) {
            err_stream.printf("Invalid bitrate: %d. Needs to be in 300-115200 range.\n", bitrate);
            return false;
        }
        return true;            
    }
    return false;
}
