ashtuchkin/vive-diy-position-sensor/(commit log)

2016-08-21 Added Mavlink & NED frame export
2016-08-22 Added invalid points filtering
2016-10-24 Update gcc-arm-embedded location & delete ADC library
2016-10-24 Switch to git submodules for libraries, core, cmsis.
2016-10-29 Get back to upstream teensy cores repo
2016-10-31 Added sensor schematics file
2016-12-07 Add 1-click-bom file (#3)
    This can be used with the browser extension: https://1clickBOM.com
    [1-click-bom.tsv]
2017-01-23 Added configuration mode & ability to have multiple sensors.
2017-01-29 Remove ADC submodule as it wasn't used.
2017-02-20 Added fix_level; Renamed ObjectPosition; Converted enums to scoped.
    [common.h, cycle_phase_classifier.cpp, debug_node.cpp, formatters.cpp, formatters.h, geometry.cpp, geometry.h, input.cpp]
2017-02-20 Added FixLevel and dist values.
    [common.h, formatters.cpp, geometry.cpp, geometry.h, message_logging.h, pulse_processor.cpp]
2017-02-21 Fixed incorrect base station cycle phase classification.
    [cycle_phase_classifier.cpp, pulse_processor.cpp, settings.cpp]
2017-02-27 Updated comparator input to work on Teensy 3.0 - 3.6.
2017-02-27 Added testing framework
2017-03-19 Added new platform: Particle Photon board.
2017-05-21 Fix InputCmpNode - it wasn't working because of off-by-one mistake
    [input_cmp.cpp]
2017-05-27 Added Hardware Timer (FTM) input source for Teensy platform
    It has a lot less jitter and more stability.
    [input.cpp, input_ftm.cpp, input_ftm.h]
2017-05-27 Minor fix: print new value when changing config
    [settings.cpp]
2021-06-24 Changed teensy loader with updated command
